OpenTrons/Smoothieboard/original_smoothieboard/README.md

Smoothieboard
=============

Smoothieboard is a free, open source, high performance and modular G-code interpreter and CNC controller for the LPC17xx micro-controller (32-bit ARM Cortex-M3).

The current BoM (Bill of Materials) can be found at https://docs.google.com/spreadsheet/ccc?key=0Api7_ZbfikkKdGRDblUwMDFWcm1CT2M2bENkQWpZZ0E&usp=drive_web#gid=0

A separate list is maintained for the connectors at https://docs.google.com/spreadsheets/d/1bT7xw4z405cyhR7MyXegm4-C2oinxpVefuf3KV13v_A/edit#gid=0

Licensed under CERN OHL v.1.2 or later http://ohwr.org/cernohl
No warranty is provided for this documentation implied or otherwise.

The policy regarding third party "clones" and "derivatives" of Smoothieboard is found at http://smoothieware.org/policy

This documentation is hosted at http://github.com/Smoothieware/Smoothieboard

Firmware is found at http://github.com/Smoothieware/Smoothieware

Documentation of use is hosted on a wiki at http://smoothieware.org

For more info or to let us know what you are doing with Smoothie email wolf.arthur@gmail.com
or join the Smoothie community on IRC Freenode in #smoothieware http://smoothieware.org/irc

Smoothieware is a certified open source hardware project (UID FR000001).

Smoothieboard, and Smoothieware, and the Smoothie-namespace are all trademarks of The Smoothie Project.
The hardware and software of The Smoothie Project are licensed under the CERN OHL v1.2 or later and GPL v3 or later licensing agreements respectively.
Copyright 2011-2016 by Arthur Wolf and Mark Cooper
