OpenTrons/Smoothieboard/original_smoothieboard/smoothieboard-5driver-schematic.pdf

A

A

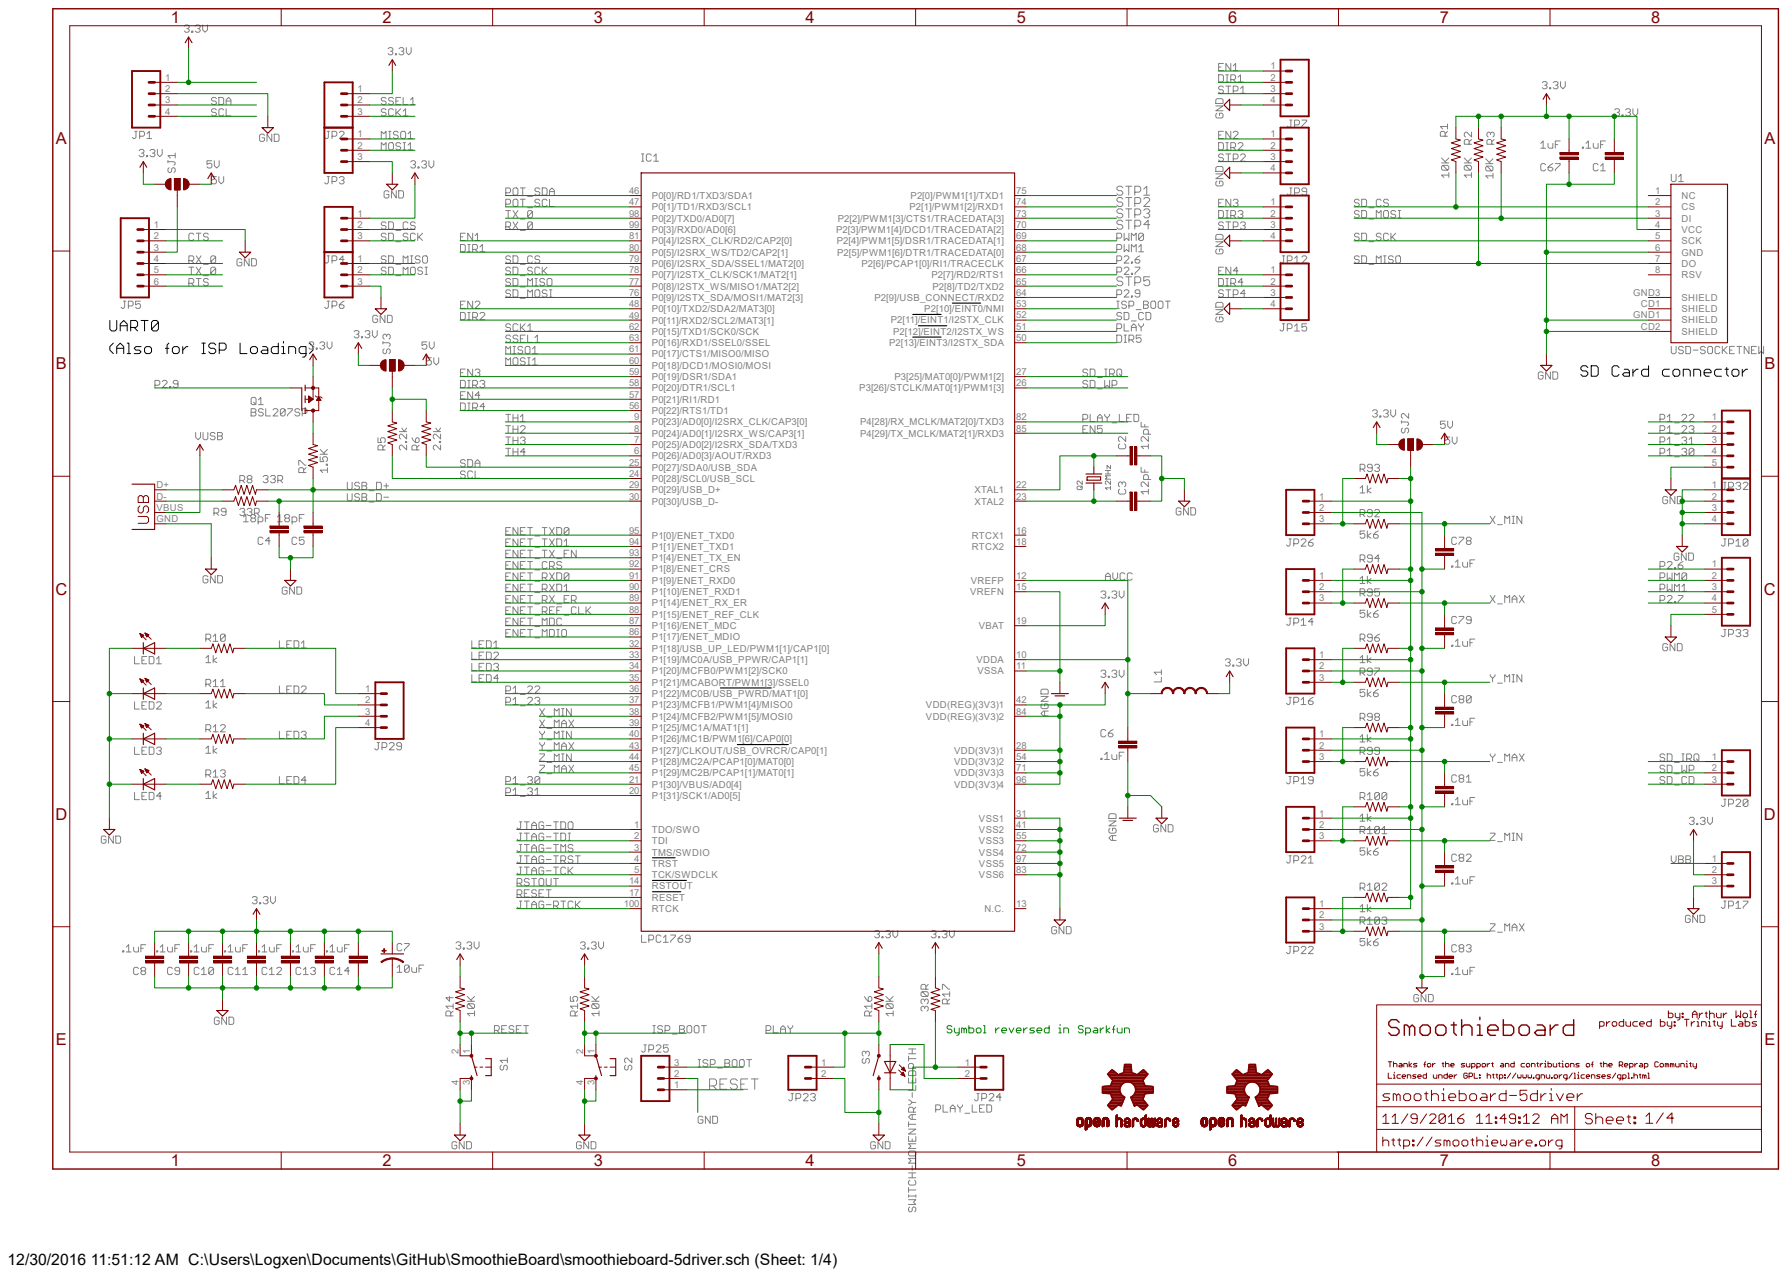
[picture p1: page 1]
TDO/SWO 1 TDI 2 TMS/SWDIO 3 TRST 4 TCK/SWDCLK 5; P0[26]/AD0[3]/AOUT/RXD3 6 P0[25]/AD0[2]/I2SRX_SDA/TXD3 7 P0[24]/AD0[1]/I2SRX_WS/CAP3[1] 8 P0[23]/AD0[0]/I2SRX_CLK/CAP3[0] 9; VDDA 10 VSSA 11; VREFP 12; RSTOUT 14; VREFN 15; RTCX1 16; RESET 17; RTCX2 18; VBAT 19; P1[31]/SCK1/AD0[5] 20 P1[30]/VBUS/AD0[4] 21; XTAL1 22 XTAL2 23; P0[28]/SCL0/USB_SCL 24 P0[27]/SDA0/USB_SDA 25; P3[26]/STCLK/MAT0[1]/PWM1[3] 26 P3[25]/MAT0[0]/PWM1[2] 27; VDD(3V3)1 28; P0[29]/USB_D+ 29 P0[30]/USB_D- 30; VSS1 31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

P2[9]/USB_CONNECT/RXD2 64 P2[8]/TD2/TXD2 65 P2[7]/RD2/RTS1 66 P2[6]/PCAP1[0]/RI1/TRACECLK 67 P2[5]/PWM1[6]/DTR1/TRACEDATA[0] 68 P2[4]/PWM1[5]/DSR1/TRACEDATA[1] 69 P2[3]/PWM1[4]/DCD1/TRACEDATA[2] 70

12/30/2016 11:51:12 AM C:\Users\Logxen\Documents\GitHub\SmoothieBoard\smoothieboard-5driver.sch (Sheet: 1/4)

A

A

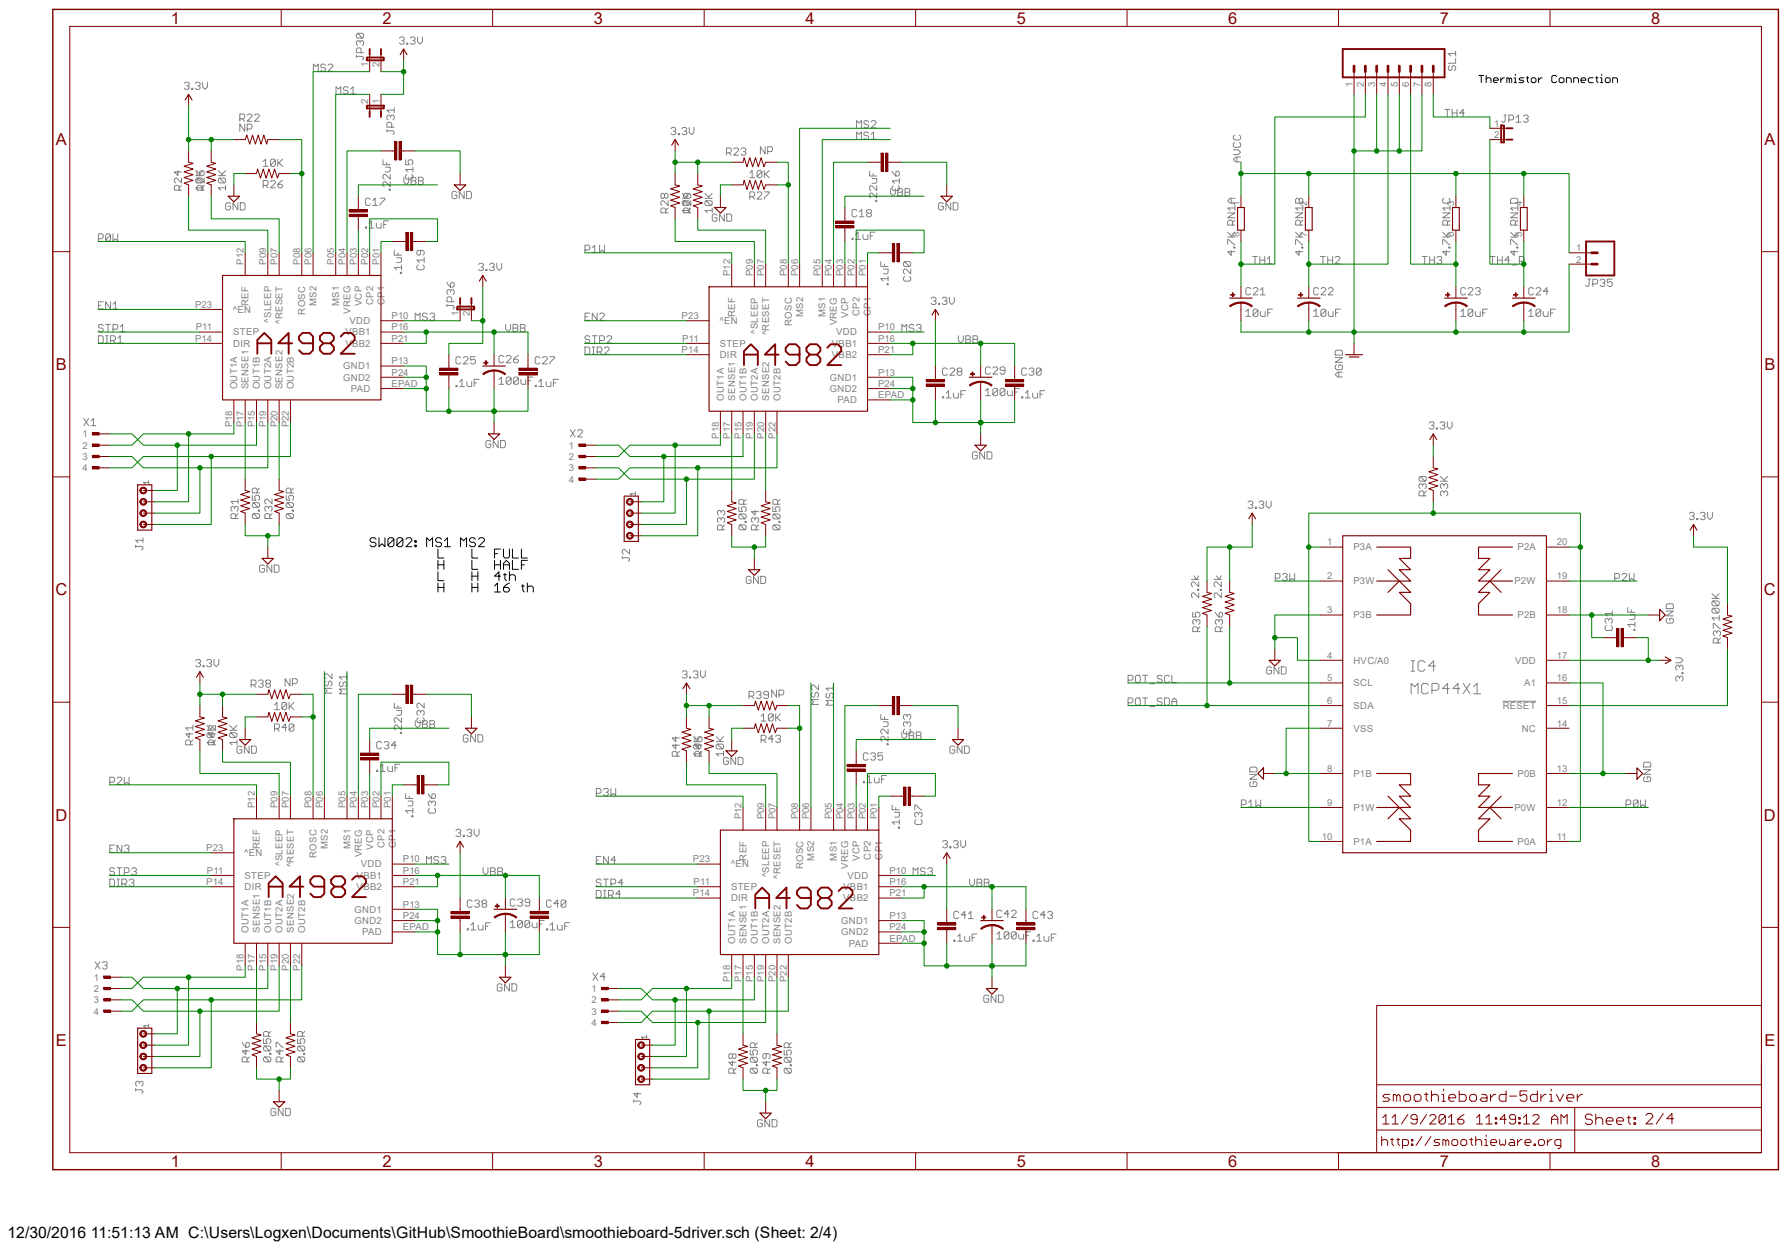
[picture p2: page 2]

12/30/2016 11:51:13 AM C:\Users\Logxen\Documents\GitHub\SmoothieBoard\smoothieboard-5driver.sch (Sheet: 2/4)

A

A

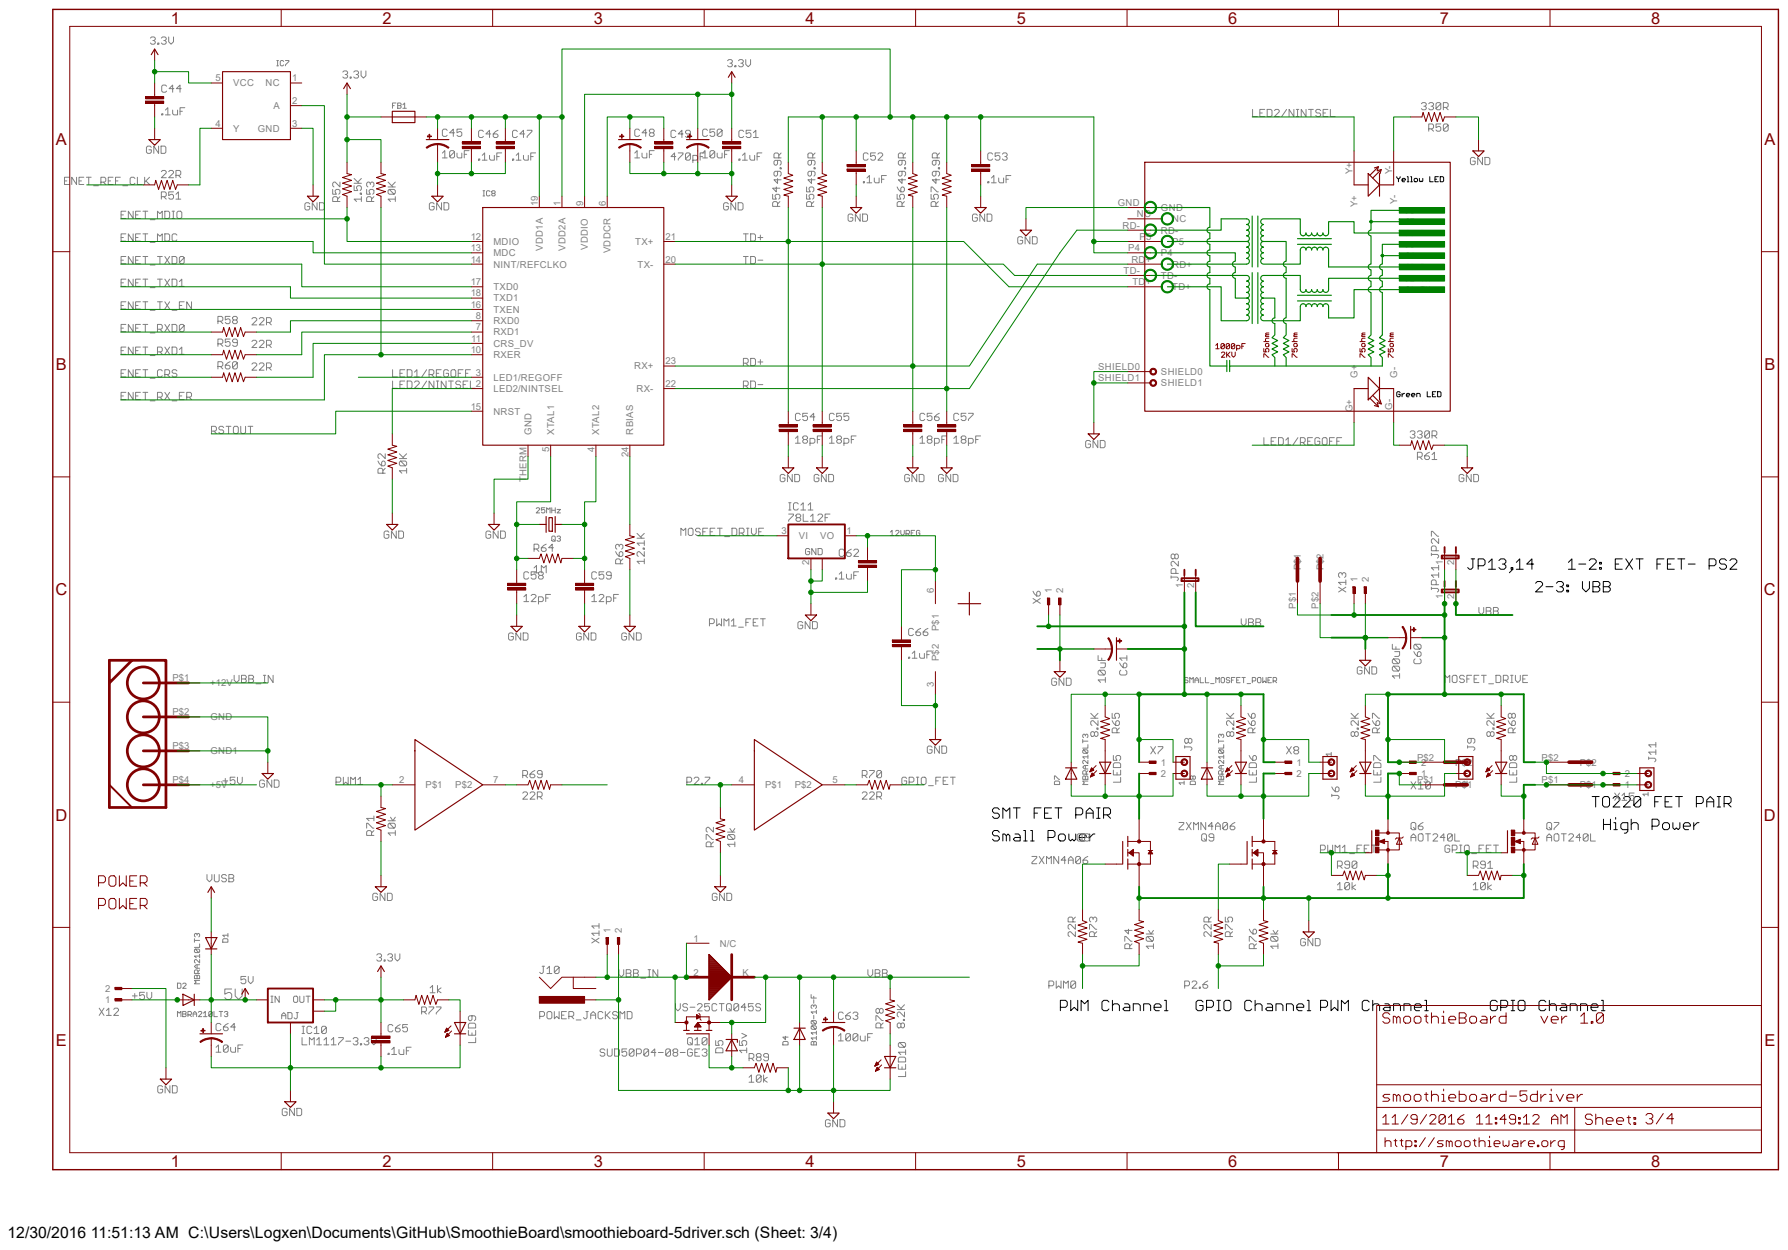
[picture p3: page 3]
MDIO 12 MDC 13 NINT/REFCLKO 14; TXD0 17 TXD1 18 TXEN 16 RXD0 8 RXD1 7; RXER 10; LED1/REGOFF 3 LED2/NINTSEL 2; NRST 15; XTAL1; XTAL2; CRS_DV 11; RBIAS 24; GND THERM; VDD1A 19; VDD2A; VDDIO; VDDCR; GND 3 Y 4; VCC 5; GND P$2; GND1 P$3; SHIELD0 SHIELD0 SHIELD1 SHIELD1

GND

12/30/2016 11:51:13 AM C:\Users\Logxen\Documents\GitHub\SmoothieBoard\smoothieboard-5driver.sch (Sheet: 3/4)

A

A

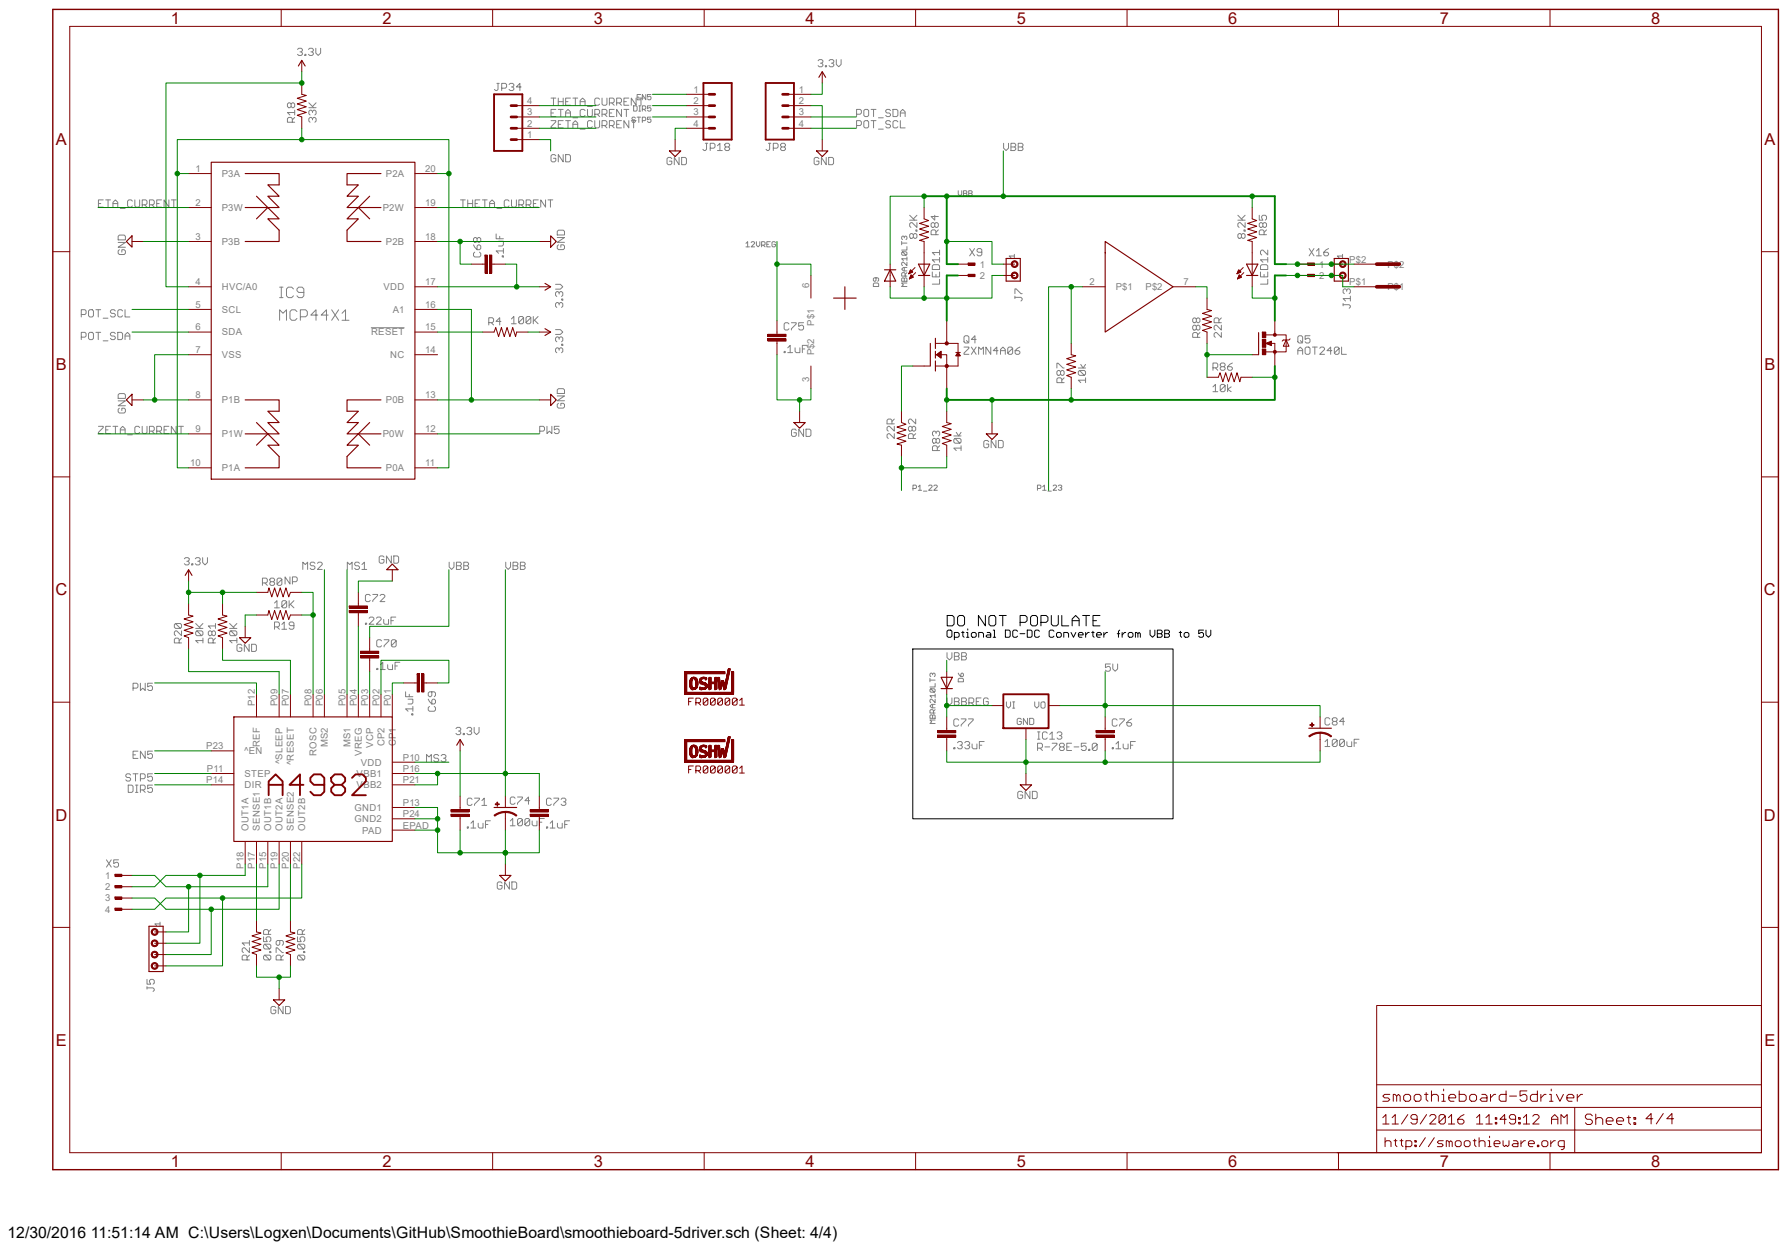
[picture p4: page 4]

12/30/2016 11:51:14 AM C:\Users\Logxen\Documents\GitHub\SmoothieBoard\smoothieboard-5driver.sch (Sheet: 4/4)
