OpenTrons/Smoothieboard/Opentrons_smoothieboard-5driver.pdf

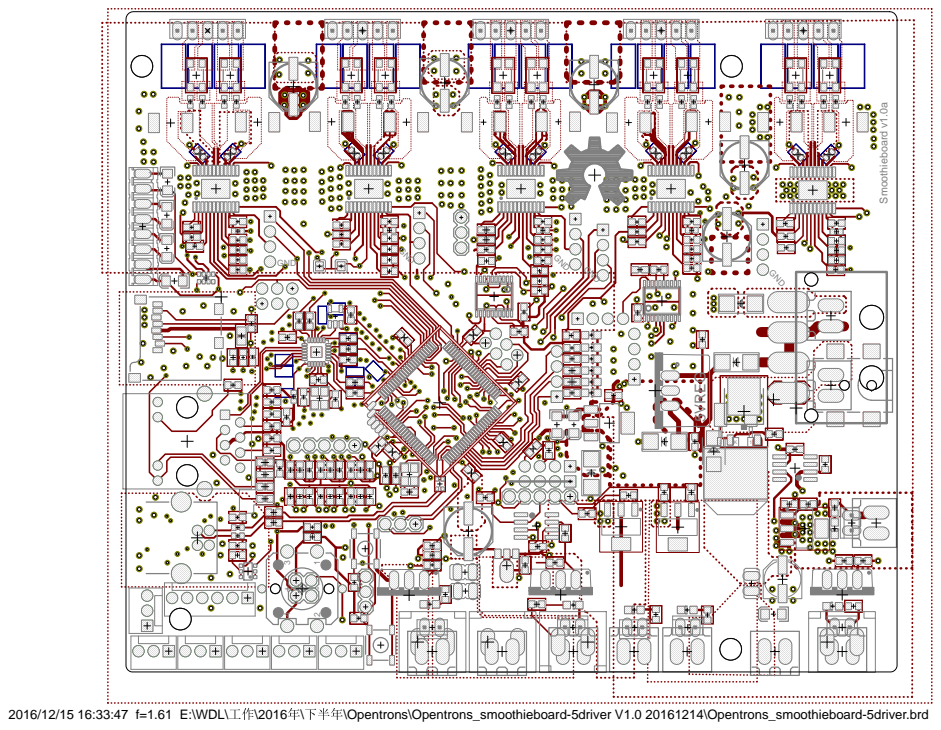
[picture p5: page 1]
2016/12/15 16:33:47 f=1.61 E:\WDL\; \Opentrons\Opentrons_smoothieboard-5driver V1.0 20161214\Opentrons_smoothieboard-5driver.brd; Smoothieboard v1.0a; 5VREG; GND; GND GND
