OpenTrons/Smoothieboard/Opentrons_smoothieboard-5driver.brd

## EAGLE design Opentrons_smoothieboard-5driver.brd (2017-04-06)

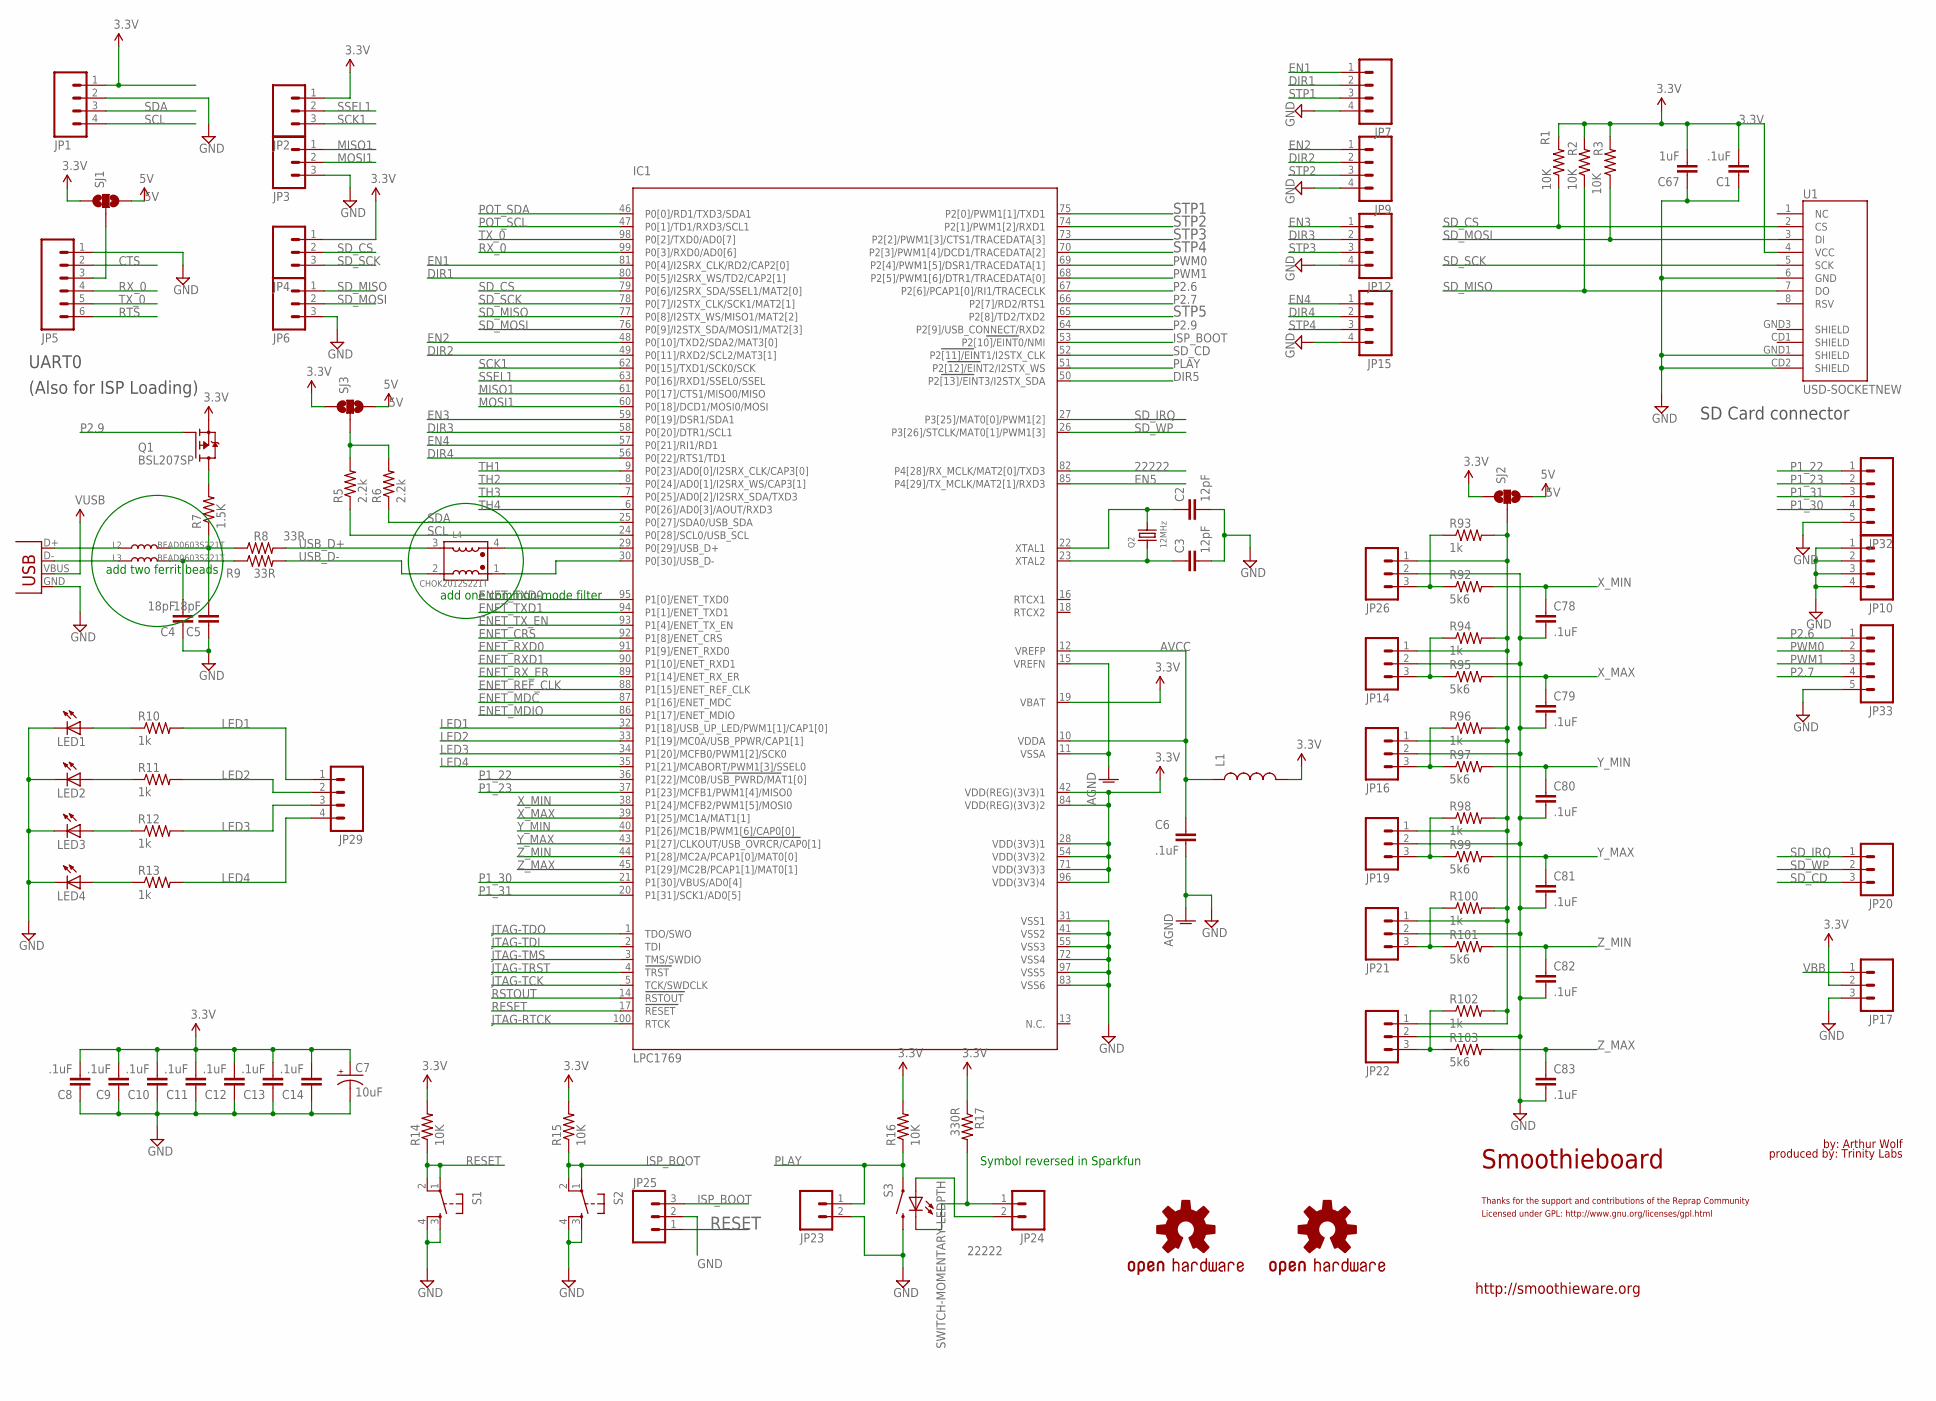
[picture p6: schematic Opentrons_smoothieboard-5driver.sch, sheet 1]

Parts:
C1, C6, C8, C9, C10, C11, C12, C13, C14, C78, C79, C80, C81, C82, C83: .1uF; C0603
C2, C3: 12pF; C0603
C4, C5: 18pF; C0603
C7: 10uF; EIA3216
C67: 1uF; C0805
IC1: LPC1769; LQFP100
JP1, JP7, JP9, JP10, JP12, JP15, JP29: M041X04_NO_SILK; 1X04_NO_SILK
JP2, JP3, JP4, JP6: M031X03_NO_SILK; 1X03_NO_SILK
JP5: M06POLAR; MOLEX-1X6
JP14, JP16, JP19, JP21, JP22, JP26: M03POLAR; MOLEX-1X3
JP17, JP20, JP25: M03PTH; 1X03
JP23, JP24: M02PTH; 1X02
JP32, JP33: M05PTH; 1X05
L1: INDUCTOR0603; 0603
L2, L3: BEAD0603S221T; 0603(1608)
L4: CHOK2012S221T; L-2012
LED1, LED2, LED3, LED4: LEDCHIP-LED0805; CHIP-LED0805
Q1: BSL207SP; SC74_INFINEON
Q2: 12MHz; CRYSTAL_3.2X2.5
R1, R2, R3, R14, R15, R16: 10K; R0603
R5, R6: 2.2k; R0603
R7: 1.5K; R0603
R8, R9: 33R; R0603
R10, R11, R12, R13, R93, R94, R96, R98, R100, R102: 1k; R0603
R17: 330R; R0603
R92, R95, R97, R99, R101, R103: 5k6; R0603
S1, S2: TAC_SWITCHSMD; TACTILE_SWITCH_SMD
S3: SWITCH-MOMENTARY-LEDPTH; TACTILE-PTH-LED-12MM
SJ1, SJ2, SJ3: SOLDERJUMPER_2WAYS; SJ_3
U1: USD-SOCKETNEW; MICRO-SD-SOCKET-PP
U$8, U$9: OSHW-LOGOH; OSHW-LOGO-HUGE
X14: USBPTH; USB-B-PTH

Connections:
3.3V: C1.2, C7.A (+), C8.2, C9.2, C10.2, C11.2, C12.2, C13.2, C14.2, C67.2, IC1.19 (VBAT), IC1.28 (VDD(3V3)1), IC1.42 (VDD(REG)(3V3)1), IC1.54 (VDD(3V3)2), IC1.71 (VDD(3V3)3), IC1.84 (VDD(REG)(3V3)2), IC1.96 (VDD(3V3)4), JP1.1, JP2.1, JP4.1, JP17.2, L1.2, Q1.4 (S), R1.2, R2.2, R3.2, R14.2, R15.2, R16.2, R17.1, SJ1.1, SJ2.1, SJ3.1, U1.4 (VCC); also elsewhere on the board
5V: SJ1.3, SJ2.3, SJ3.3; also elsewhere on the board
22222: IC1.82 (P4[28]/RX_MCLK/MAT2[0]/TXD3), JP24.2, S3.A
AGND: C6.2, IC1.11 (VSSA), IC1.15 (VREFN); also elsewhere on the board
AVCC: C6.1, IC1.10 (VDDA), IC1.12 (VREFP), L1.1; also elsewhere on the board
CTS: JP5.2
DIR1: IC1.80 (P0[5]/I2SRX_WS/TD2/CAP2[1]), JP7.2; also elsewhere on the board
DIR2: IC1.49 (P0[11]/RXD2/SCL2/MAT3[1]), JP9.2; also elsewhere on the board
DIR3: IC1.58 (P0[20]/DTR1/SCL1), JP12.2; also elsewhere on the board
DIR4: IC1.56 (P0[22]/RTS1/TD1), JP15.2; also elsewhere on the board
DIR5: IC1.50 (P2[13]/EINT3/I2STX_SDA); also elsewhere on the board
EN1: IC1.81 (P0[4]/I2SRX_CLK/RD2/CAP2[0]), JP7.1; also elsewhere on the board
EN2: IC1.48 (P0[10]/TXD2/SDA2/MAT3[0]), JP9.1; also elsewhere on the board
EN3: IC1.59 (P0[19]/DSR1/SDA1), JP12.1; also elsewhere on the board
EN4: IC1.57 (P0[21]/RI1/RD1), JP15.1; also elsewhere on the board
EN5: IC1.85 (P4[29]/TX_MCLK/MAT2[1]/RXD3); also elsewhere on the board
ENET_CRS: IC1.92 (P1[8]/ENET_CRS); also elsewhere on the board
ENET_MDC: IC1.87 (P1[16]/ENET_MDC); also elsewhere on the board
ENET_MDIO: IC1.86 (P1[17]/ENET_MDIO); also elsewhere on the board
ENET_REF_CLK: IC1.88 (P1[15]/ENET_REF_CLK); also elsewhere on the board
ENET_RXD0: IC1.91 (P1[9]/ENET_RXD0); also elsewhere on the board
ENET_RXD1: IC1.90 (P1[10]/ENET_RXD1); also elsewhere on the board
ENET_RX_ER: IC1.89 (P1[14]/ENET_RX_ER); also elsewhere on the board
ENET_TXD0: IC1.95 (P1[0]/ENET_TXD0); also elsewhere on the board
ENET_TXD1: IC1.94 (P1[1]/ENET_TXD1); also elsewhere on the board
ENET_TX_EN: IC1.93 (P1[4]/ENET_TX_EN); also elsewhere on the board
GND: C1.1, C2.2, C3.2, C4.1, C5.1, C7.C (-), C8.1, C9.1, C10.1, C11.1, C12.1, C13.1, C14.1, C67.1, C78.2, C79.2, C80.2, C81.2, C82.2, C83.2, IC1.31 (VSS1), IC1.41 (VSS2), IC1.55 (VSS3), IC1.72 (VSS4), IC1.83 (VSS6), IC1.97 (VSS5), JP1.2, JP3.3, JP5.1, JP6.3, JP7.4, JP9.4, JP10.1, JP10.2, JP10.3, JP10.4, JP12.4, JP14.2, JP15.4, JP16.2, JP17.3, JP19.2, JP21.2, JP22.2, JP23.2, JP25.2, JP26.2, JP32.5, JP33.5, LED1.C, LED2.C, LED3.C, LED4.C, S1.3, S1.4, S2.3, S2.4, S3.2, U1.6 (GND), U1.CD2 (SHIELD), U1.GND1 (SHIELD), X14.GND; also elsewhere on the board
ISP_BOOT: IC1.53 (P2[10]/EINT0/NMI), JP25.3, R15.1, S2.1, S2.2
JTAG-RTCK: IC1.100 (RTCK)
JTAG-TCK: IC1.5 (TCK/SWDCLK)
JTAG-TDI: IC1.2 (TDI)
JTAG-TDO: IC1.1 (TDO/SWO)
JTAG-TMS: IC1.3 (TMS/SWDIO)
JTAG-TRST: IC1.4 (TRST)
LED1: IC1.32 (P1[18]/USB_UP_LED/PWM1[1]/CAP1[0]), JP29.1, R10.2
LED2: IC1.33 (P1[19]/MC0A/USB_PPWR/CAP1[1]), JP29.2, R11.2
LED3: IC1.34 (P1[20]/MCFB0/PWM1[2]/SCK0), JP29.3, R12.2
LED4: IC1.35 (P1[21]/MCABORT/PWM1[3]/SSEL0), JP29.4, R13.2
MISO1: IC1.61 (P0[17]/CTS1/MISO0/MISO), JP3.1
MOSI1: IC1.60 (P0[18]/DCD1/MOSI0/MOSI), JP3.2
unnamed: C2.1, IC1.22 (XTAL1), Q2.2
unnamed: C3.1, IC1.23 (XTAL2), Q2.1
unnamed: JP5.3, SJ1.2
unnamed: Q1.1 (D), Q1.2 (D), Q1.5 (D), Q1.6 (D), R7.2
unnamed: L2.1, X14.D+
unnamed: L3.1, X14.D-
unnamed: JP24.1, R17.2, S3.C
unnamed: LED4.A, R13.1
unnamed: LED3.A, R12.1
unnamed: LED2.A, R11.1
unnamed: LED1.A, R10.1
unnamed: JP14.3, R94.1, R95.1
unnamed: JP14.1, JP16.1, JP19.1, JP21.1, JP22.1, JP26.1, R93.2, R94.2, R96.2, R98.2, R100.2, R102.2, SJ2.2
unnamed: JP16.3, R96.1, R97.1
unnamed: JP19.3, R98.1, R99.1
unnamed: JP22.3, R102.1, R103.1
unnamed: JP21.3, R100.1, R101.1
unnamed: JP26.3, R92.1, R93.1
unnamed: R5.2, R6.2, SJ3.2
unnamed: C5.2, L2.2, R7.1, R8.1
unnamed: C4.2, L3.2, R9.1
unnamed: IC1.30 (P0[30]/USB_D-), L4.1
unnamed: IC1.29 (P0[29]/USB_D+), L4.4
P1_22: IC1.36 (P1[22]/MC0B/USB_PWRD/MAT1[0]), JP32.1; also elsewhere on the board
P1_23: IC1.37 (P1[23]/MCFB1/PWM1[4]/MISO0), JP32.2; also elsewhere on the board
P1_30: IC1.21 (P1[30]/VBUS/AD0[4]), JP32.4
P1_31: IC1.20 (P1[31]/SCK1/AD0[5]), JP32.3
P2.6: IC1.67 (P2[6]/PCAP1[0]/RI1/TRACECLK), JP33.1; also elsewhere on the board
P2.7: IC1.66 (P2[7]/RD2/RTS1), JP33.4; also elsewhere on the board
P2.9: IC1.64 (P2[9]/USB_CONNECT/RXD2), Q1.3 (G)
PLAY: IC1.51 (P2[12]/EINT2/I2STX_WS), JP23.1, R16.1, S3.4 (1)
POT_SCL: IC1.47 (P0[1]/TD1/RXD3/SCL1); also elsewhere on the board
POT_SDA: IC1.46 (P0[0]/RD1/TXD3/SDA1); also elsewhere on the board
PWM0: IC1.69 (P2[4]/PWM1[5]/DSR1/TRACEDATA[1]), JP33.2; also elsewhere on the board
PWM1: IC1.68 (P2[5]/PWM1[6]/DTR1/TRACEDATA[0]), JP33.3; also elsewhere on the board
RESET: IC1.17 (RESET), JP25.1, R14.1, S1.1, S1.2
RSTOUT: IC1.14 (RSTOUT); also elsewhere on the board
RTS: JP5.6
RX_0: IC1.99 (P0[3]/RXD0/AD0[6]), JP5.4
SCK1: IC1.62 (P0[15]/TXD1/SCK0/SCK), JP2.3
SCL: IC1.24 (P0[28]/SCL0/USB_SCL), JP1.4, R5.1
SDA: IC1.25 (P0[27]/SDA0/USB_SDA), JP1.3, R6.1
SD_CD: IC1.52 (P2[11]/EINT1/I2STX_CLK), JP20.3
SD_CS: IC1.79 (P0[6]/I2SRX_SDA/SSEL1/MAT2[0]), JP4.2, R1.1, U1.2 (CS)
SD_IRQ: IC1.27 (P3[25]/MAT0[0]/PWM1[2]), JP20.1
SD_MISO: IC1.77 (P0[8]/I2STX_WS/MISO1/MAT2[2]), JP6.1, R2.1, U1.7 (DO)
SD_MOSI: IC1.76 (P0[9]/I2STX_SDA/MOSI1/MAT2[3]), JP6.2, R3.1, U1.3 (DI)
SD_SCK: IC1.78 (P0[7]/I2STX_CLK/SCK1/MAT2[1]), JP4.3, U1.5 (SCK)
SD_WP: IC1.26 (P3[26]/STCLK/MAT0[1]/PWM1[3]), JP20.2
SSEL1: IC1.63 (P0[16]/RXD1/SSEL0/SSEL), JP2.2
STP1: IC1.75 (P2[0]/PWM1[1]/TXD1), JP7.3; also elsewhere on the board
STP2: IC1.74 (P2[1]/PWM1[2]/RXD1), JP9.3; also elsewhere on the board
STP3: IC1.73 (P2[2]/PWM1[3]/CTS1/TRACEDATA[3]), JP12.3; also elsewhere on the board
STP4: IC1.70 (P2[3]/PWM1[4]/DCD1/TRACEDATA[2]), JP15.3; also elsewhere on the board
STP5: IC1.65 (P2[8]/TD2/TXD2); also elsewhere on the board
TH1: IC1.9 (P0[23]/AD0[0]/I2SRX_CLK/CAP3[0]); also elsewhere on the board
TH2: IC1.8 (P0[24]/AD0[1]/I2SRX_WS/CAP3[1]); also elsewhere on the board
TH3: IC1.7 (P0[25]/AD0[2]/I2SRX_SDA/TXD3); also elsewhere on the board
TH4: IC1.6 (P0[26]/AD0[3]/AOUT/RXD3); also elsewhere on the board
TX_0: IC1.98 (P0[2]/TXD0/AD0[7]), JP5.5
USB_D+: L4.3, R8.2
USB_D-: L4.2, R9.2
VBB: JP17.1; also elsewhere on the board
VUSB: X14.VBUS; also elsewhere on the board
X_MAX: C79.1, IC1.39 (P1[25]/MC1A/MAT1[1]), R95.2
X_MIN: C78.1, IC1.38 (P1[24]/MCFB2/PWM1[5]/MOSI0), R92.2
Y_MAX: C81.1, IC1.43 (P1[27]/CLKOUT/USB_OVRCR/CAP0[1]), R99.2
Y_MIN: C80.1, IC1.40 (P1[26]/MC1B/PWM1[6]/CAP0[0]), R97.2
Z_MAX: C83.1, IC1.45 (P1[29]/MC2B/PCAP1[1]/MAT0[1]), R103.2
Z_MIN: C82.1, IC1.44 (P1[28]/MC2A/PCAP1[0]/MAT0[0]), R101.2

Notes on the sheet:
SD Card connector
UART0
(Also for ISP Loading)
http://smoothieware.org
Symbol reversed in Sparkfun
Smoothieboard
by: Arthur Wolf
produced by: Trinity Labs
Licensed under GPL: http://www.gnu.org/licenses/gpl.html
Thanks for the support and contributions of the Reprap Community
add two ferrit beads
add one common-mode filter

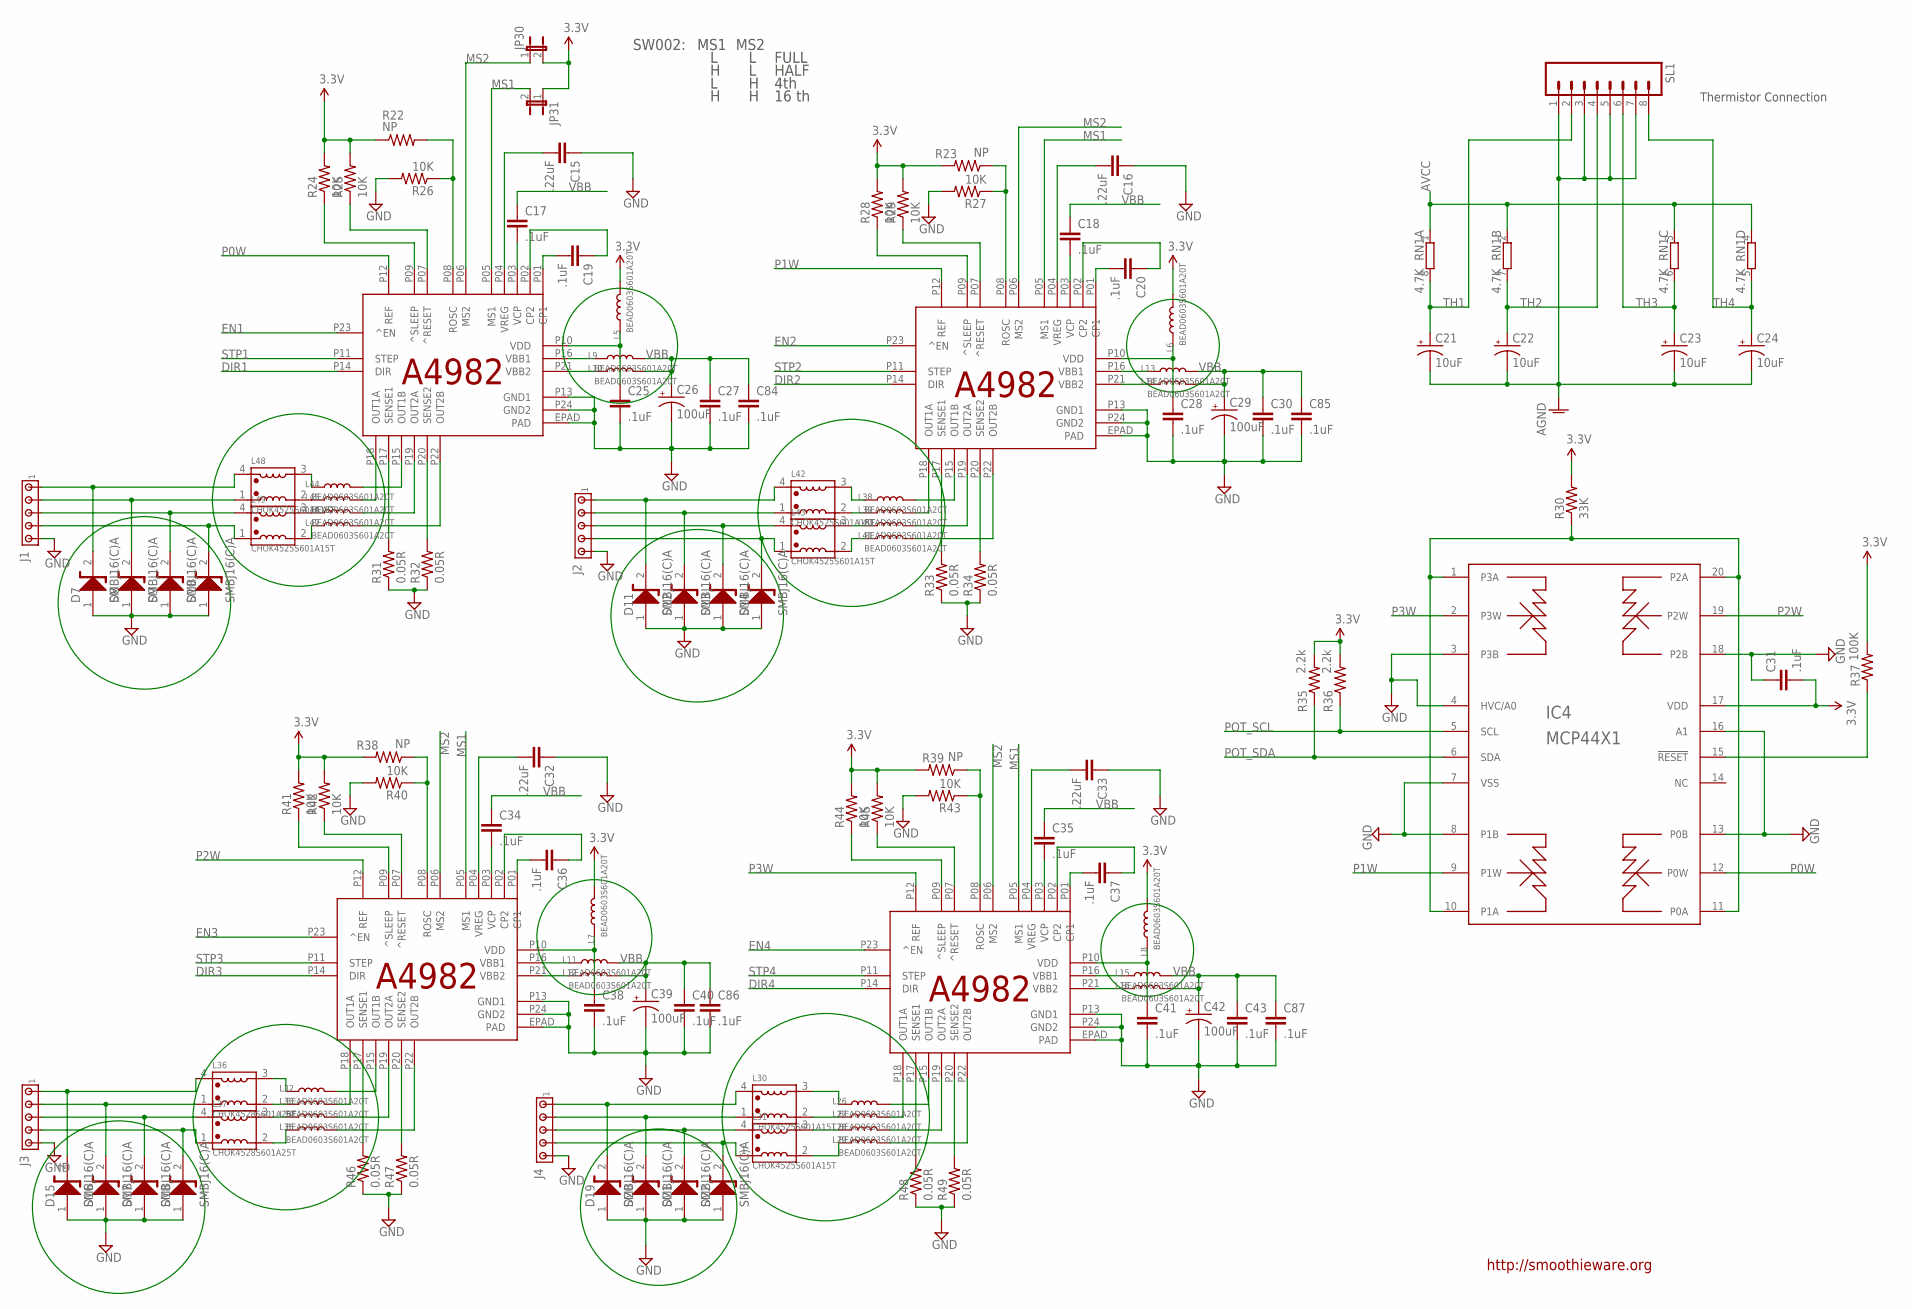
[picture p7: schematic Opentrons_smoothieboard-5driver.sch, sheet 2]

Parts:
C15, C16, C32, C33: .22uF; C0603
C17, C18, C19, C20, C25, C27, C28, C30, C31, C34, C35, C36, C37, C38, C40, C41, C43, C84, C85, C86, C87: .1uF; C0603
C21, C22, C23, C24: 10uF; EIA3216
C26, C29, C39, C42: 100uF; PANASONIC_E
D7, D8, D9, D10, D11, D12, D13, D14, D15, D16, D17, D18, D19, D20, D21, D22: SMBJ16(C)A; DO214-AA_(SMB)
IC2, IC3, IC5, IC6: A4982; ETSSOP24
IC4: MCP44X1; TSSOP20
J1, J2, J3, J4: MTA05-100; 10X05MTA
JP30, JP31: JUMPER-2SMD-NC; SJ_2S
L5, L6, L7, L8, L9, L10, L11, L12, L13, L14, L15, L16, L26, L27, L28, L29, L32, L33, L34, L35, L38, L39, L40, L41, L44, L45, L46, L47: BEAD0603S601A20T; 0603(1608)
L30, L31, L42, L43, L48, L49: CHOK4525S601A15T; L-4525
L36, L37: CHOK4528S601A25T; L-4528
R22, R23, R38, R39: NP; R0603
R24, R25, R26, R27, R28, R29, R40, R41, R42, R43, R44, R45: 10K; R0603
R30: 33K; R0603
R31, R32, R33, R34, R46, R47, R48, R49: 0.05R; R2512
R35, R36: 2.2k; R0603
R37: 100K; R0603
RN1: 4.7K; 0603-ARV
SL1: M08; 08P

Connections:
3.3V: C31.2, IC4.17 (VDD), JP30.2, JP31.1, L5.2, L6.2, L7.2, L8.2, R22.1, R23.2, R24.2, R25.2, R28.2, R29.2, R30.2, R35.2, R36.2, R37.2, R38.2, R39.2, R41.2, R42.2, R44.2, R45.2; also elsewhere on the board
AGND: C21.C (-), C22.C (-), C23.C (-), C24.C (-), SL1.1, SL1.3, SL1.5, SL1.7; also elsewhere on the board
AVCC: RN1.1, RN1.2 (1), RN1.3 (1), RN1.4 (1); also elsewhere on the board
DIR1: IC2.P14 (DIR); also elsewhere on the board
DIR2: IC3.P14 (DIR); also elsewhere on the board
DIR3: IC5.P14 (DIR); also elsewhere on the board
DIR4: IC6.P14 (DIR); also elsewhere on the board
EN1: IC2.P23 (^EN); also elsewhere on the board
EN2: IC3.P23 (^EN); also elsewhere on the board
EN3: IC5.P23 (^EN); also elsewhere on the board
EN4: IC6.P23 (^EN); also elsewhere on the board
GND: C15.1, C16.1, C25.2, C26.-, C27.2, C28.2, C29.-, C30.2, C31.1, C32.1, C33.1, C38.2, C39.-, C40.2, C41.2, C42.-, C43.2, C84.2, C85.2, C86.2, C87.2, D7.1 (A), D8.1 (A), D9.1 (A), D10.1 (A), D11.1 (A), D12.1 (A), D13.1 (A), D14.1 (A), D15.1 (A), D16.1 (A), D17.1 (A), D18.1 (A), D19.1 (A), D20.1 (A), D21.1 (A), D22.1 (A), IC2.EPAD (PAD), IC2.P13 (GND1), IC2.P24 (GND2), IC3.EPAD (PAD), IC3.P13 (GND1), IC3.P24 (GND2), IC4.3 (P3B), IC4.4 (HVC/A0), IC4.7 (VSS), IC4.8 (P1B), IC4.13 (P0B), IC4.16 (A1), IC4.18 (P2B), IC5.EPAD (PAD), IC5.P13 (GND1), IC5.P24 (GND2), IC6.EPAD (PAD), IC6.P13 (GND1), IC6.P24 (GND2), J1.5, J2.5, J3.5, J4.5, R26.2, R27.2, R31.1, R32.1, R33.1, R34.1, R40.2, R43.2, R46.1, R47.1, R48.1, R49.1; also elsewhere on the board
J1_1A: D7.2 (K), J1.1, L48.4
J1_1B: D8.2 (K), J1.2, L48.1
J1_2A: D9.2 (K), J1.3, L49.4
J1_2B: D10.2 (K), J1.4, L49.1
J2_1A: D11.2 (K), J2.1, L42.4
J2_1B: D12.2 (K), J2.2, L42.1
J2_2A: D13.2 (K), J2.3, L43.4
J2_2B: D14.2 (K), J2.4, L43.1
J3_1A: D15.2 (K), J3.1, L36.4
J3_1B: D16.2 (K), J3.2, L36.1
J3_2A: D17.2 (K), J3.3, L37.4
J3_2B: D18.2 (K), J3.4, L37.1
J4_1A: D19.2 (K), J4.1, L30.4
J4_1B: D20.2 (K), J4.2, L30.1
J4_2A: D21.2 (K), J4.3, L31.4
J4_2B: D22.2 (K), J4.4, L31.1
MS1: IC2.P05 (MS1), IC3.P05 (MS1), IC5.P05 (MS1), IC6.P05 (MS1), JP31.2; also elsewhere on the board
MS2: IC2.P06 (MS2), IC3.P06 (MS2), IC5.P06 (MS2), IC6.P06 (MS2), JP30.1; also elsewhere on the board
unnamed: C20.2, IC3.P01 (CP1)
unnamed: C20.1, IC3.P02 (CP2)
unnamed: IC2.P07 (^RESET), R25.1
unnamed: C18.2, IC3.P03 (VCP)
unnamed: IC3.P17 (SENSE1), R33.2
unnamed: IC3.P20 (SENSE2), R34.2
unnamed: IC3.P18 (OUT1A), L39.2
unnamed: IC3.P19 (OUT2A), L40.2
unnamed: IC4.15 (!RESET), R37.1
unnamed: IC3.P22 (OUT2B), L41.2
unnamed: IC4.1 (P3A), IC4.10 (P1A), IC4.11 (P0A), IC4.20 (P2A), R30.1
unnamed: IC3.P08 (ROSC), R23.1, R27.1
unnamed: C16.2, IC3.P04 (VREG)
unnamed: IC3.P09 (^SLEEP), R28.1
unnamed: C36.2, IC5.P01 (CP1)
unnamed: C36.1, IC5.P02 (CP2)
unnamed: C34.2, IC5.P03 (VCP)
unnamed: IC5.P17 (SENSE1), R46.2
unnamed: IC5.P20 (SENSE2), R47.2
unnamed: IC5.P18 (OUT1A), L33.2
unnamed: IC5.P15 (OUT1B), L32.2
unnamed: IC5.P19 (OUT2A), L34.2
unnamed: IC5.P22 (OUT2B), L35.2
unnamed: IC3.P07 (^RESET), R29.1
unnamed: IC5.P07 (^RESET), R42.1
unnamed: IC5.P08 (ROSC), R38.1, R40.1
unnamed: C32.2, IC5.P04 (VREG)
unnamed: IC6.P07 (^RESET), R45.1
unnamed: IC5.P09 (^SLEEP), R41.1
unnamed: C37.2, IC6.P01 (CP1)
unnamed: C37.1, IC6.P02 (CP2)
unnamed: C35.2, IC6.P03 (VCP)
unnamed: IC6.P17 (SENSE1), R48.2
unnamed: IC6.P20 (SENSE2), R49.2
unnamed: IC6.P15 (OUT1B), L26.2
unnamed: IC6.P19 (OUT2A), L28.2
unnamed: IC6.P22 (OUT2B), L29.2
unnamed: IC6.P08 (ROSC), R39.1, R43.1
unnamed: C33.2, IC6.P04 (VREG)
unnamed: IC6.P09 (^SLEEP), R44.1
unnamed: IC6.P18 (OUT1A), L27.2
unnamed: C19.2, IC2.P01 (CP1)
unnamed: C19.1, IC2.P02 (CP2)
unnamed: C17.2, IC2.P03 (VCP)
unnamed: IC2.P17 (SENSE1), R31.2
unnamed: IC2.P20 (SENSE2), R32.2
unnamed: IC2.P18 (OUT1A), L45.2
unnamed: IC2.P15 (OUT1B), L44.2
unnamed: IC2.P19 (OUT2A), L46.2
unnamed: IC2.P22 (OUT2B), L47.2
unnamed: IC2.P08 (ROSC), R22.2, R26.1
unnamed: C15.2, IC2.P04 (VREG)
unnamed: IC2.P09 (^SLEEP), R24.1
unnamed: C25.1, IC2.P10 (VDD), L5.1
unnamed: C38.1, IC5.P10 (VDD), L7.1
unnamed: C28.1, IC3.P10 (VDD), L6.1
unnamed: C41.1, IC6.P10 (VDD), L8.1
unnamed: IC2.P16 (VBB1), L9.1
unnamed: IC2.P21 (VBB2), L10.1
unnamed: IC3.P16 (VBB1), L13.1
unnamed: IC3.P21 (VBB2), L14.1
unnamed: IC5.P16 (VBB1), L11.1
unnamed: IC5.P21 (VBB2), L12.1
unnamed: IC6.P16 (VBB1), L15.1
unnamed: IC6.P21 (VBB2), L16.1
unnamed: L26.1, L30.3
unnamed: L27.1, L30.2
unnamed: L28.1, L31.3
unnamed: L29.1, L31.2
unnamed: L33.1, L36.2
unnamed: L34.1, L37.3
unnamed: L32.1, L36.3
unnamed: L35.1, L37.2
unnamed: IC3.P15 (OUT1B), L38.2
unnamed: L40.1, L43.3
unnamed: L39.1, L42.2
unnamed: L41.1, L43.2
unnamed: L38.1, L42.3
unnamed: L45.1, L48.2
unnamed: L46.1, L49.3
unnamed: L44.1, L48.3
unnamed: L47.1, L49.2
P0W: IC2.P12 (REF), IC4.12 (P0W)
P1W: IC3.P12 (REF), IC4.9 (P1W)
P2W: IC4.19 (P2W), IC5.P12 (REF)
P3W: IC4.2 (P3W), IC6.P12 (REF)
POT_SCL: IC4.5 (SCL), R36.1; also elsewhere on the board
POT_SDA: IC4.6 (SDA), R35.1; also elsewhere on the board
STP1: IC2.P11 (STEP); also elsewhere on the board
STP2: IC3.P11 (STEP); also elsewhere on the board
STP3: IC5.P11 (STEP); also elsewhere on the board
STP4: IC6.P11 (STEP); also elsewhere on the board
TH1: C21.A (+), RN1.8 (2), SL1.2; also elsewhere on the board
TH2: C22.A (+), RN1.7 (2), SL1.4; also elsewhere on the board
TH3: C23.A (+), RN1.6 (2), SL1.6; also elsewhere on the board
TH4: C24.A (+), RN1.5 (2), SL1.8; also elsewhere on the board
VBB: C17.1, C18.1, C26.+, C27.1, C29.+, C30.1, C34.1, C35.1, C39.+, C40.1, C42.+, C43.1, C84.1, C85.1, C86.1, C87.1, L9.2, L10.2, L11.2, L12.2, L13.2, L14.2, L15.2, L16.2; also elsewhere on the board

Notes on the sheet:
SW002:
MS1
MS2
FULL
HALF
4th
16 th
Thermistor Connection
http://smoothieware.org

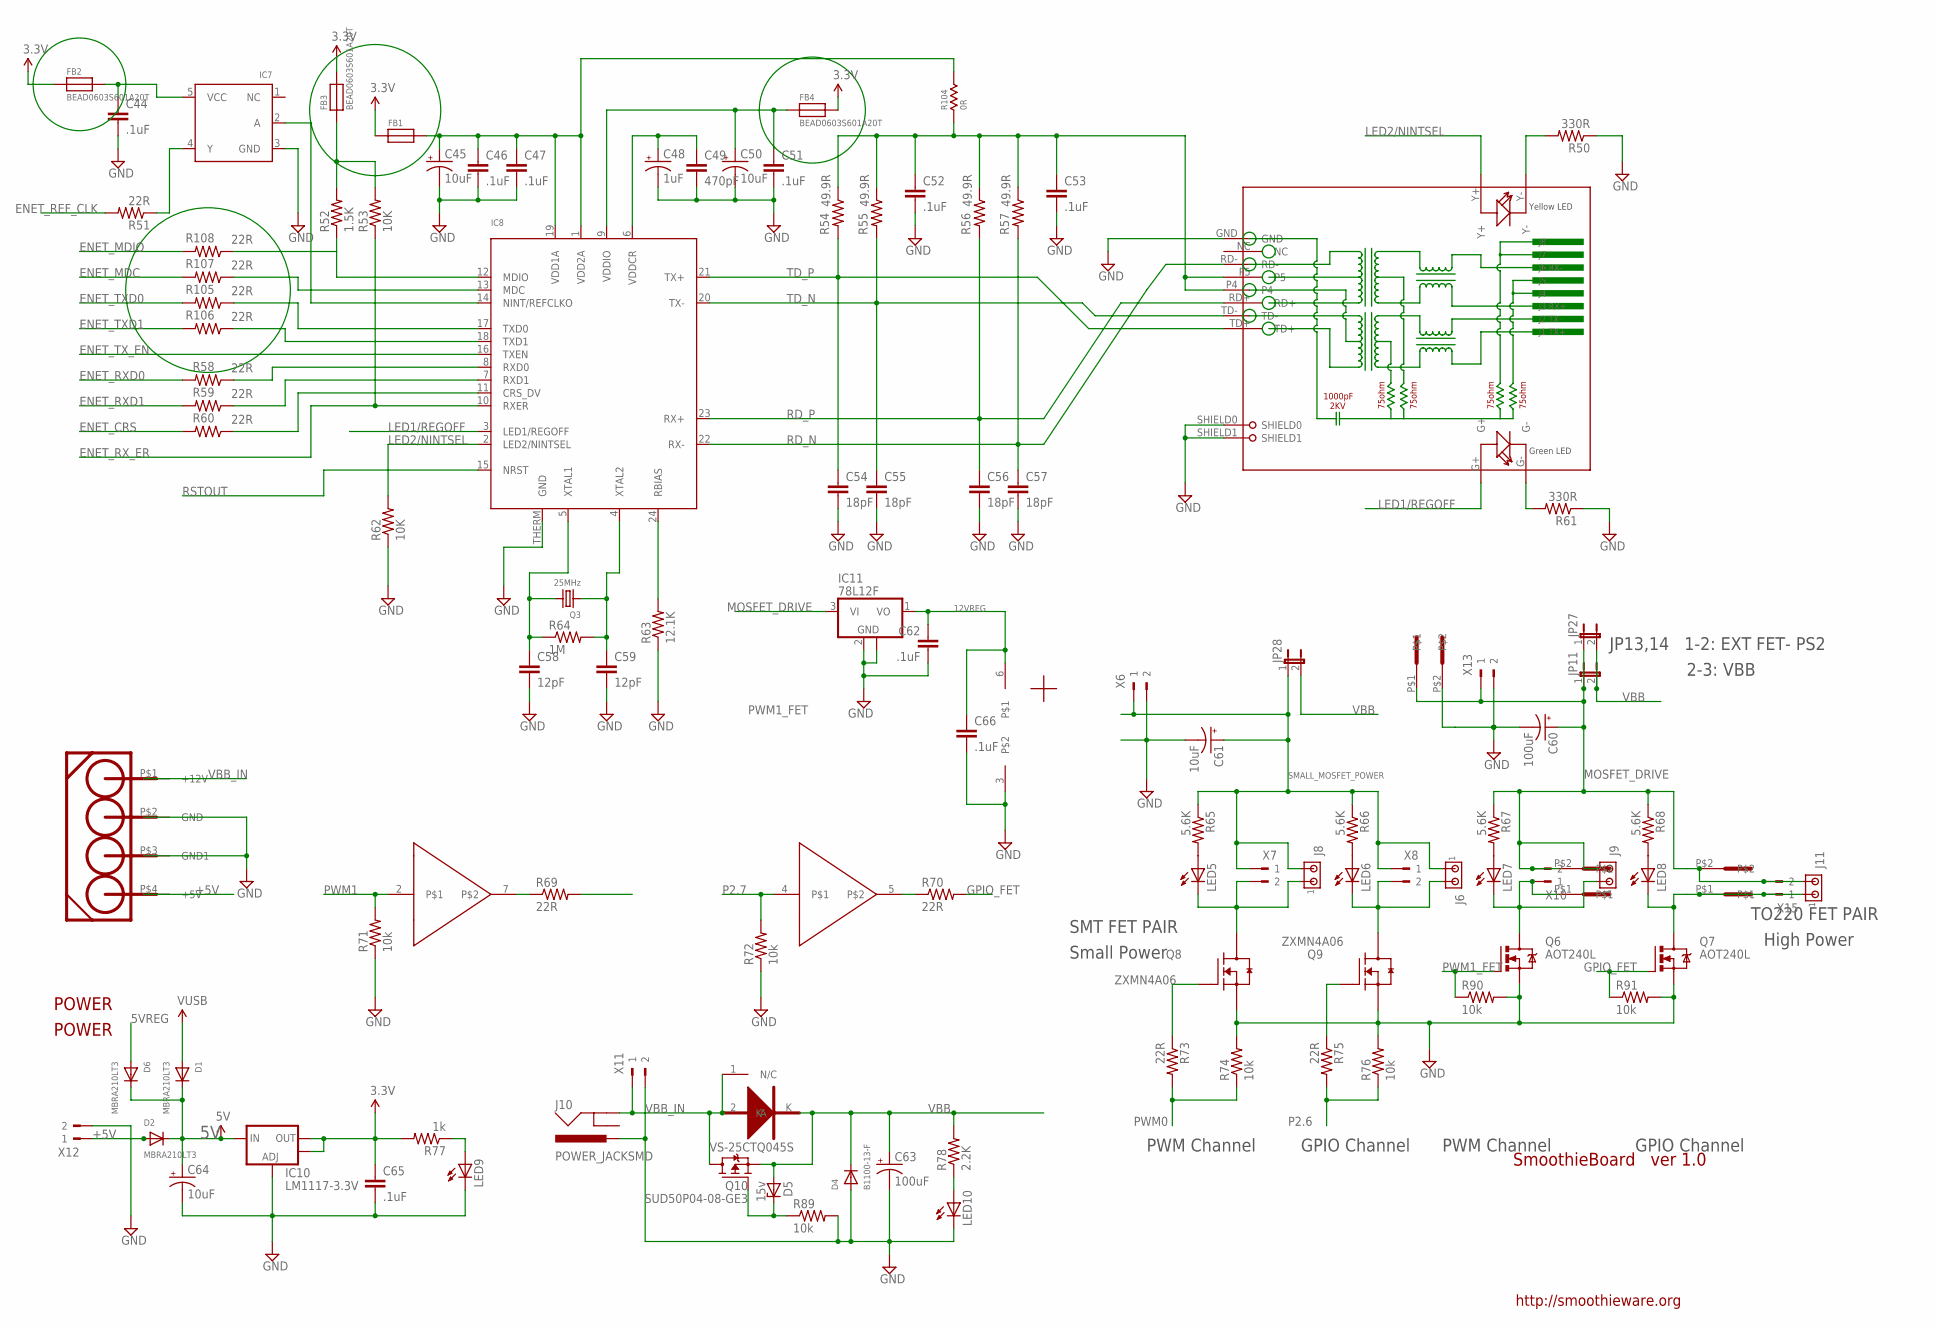
[picture p8: schematic Opentrons_smoothieboard-5driver.sch, sheet 3]

Parts:
C44, C46, C47, C51, C52, C53, C62, C65, C66: .1uF; C0603
C45, C50, C61, C64: 10uF; EIA3216
C48: 1uF; EIA3216
C49: 470pF; C0603K
C54, C55, C56, C57: 18pF; C0603
C58, C59: 12pF; C0603
C60: 100uF; PANASONIC_E
C63: 100uF; PANASONIC_D
D1, D2, D6: MBRA210LT3; SMADIODE
D3: VS-25CTQ045S; TO263AB
D4: B1100-13-F; SMADIODE
D5: 15v; SMB
FB1: FERRITE; 0603
FB2, FB3, FB4: BEAD0603S601A20T; 0603
IC7: 74LVC1G04; SOT23-5
IC8: LAN8720; QFN24_4MM
IC10: LM1117-3.3V; SOT223
IC11: 78L12F; SOT89
IC14: TC4427; SOIC8
J6, J8, J9, J11: MTA02-100; 10X02MTA
J10: POWER_JACKSMD; POWER_JACK_SMD
JP11, JP27, JP28: JP1E; JP1
LED5, LED6, LED7, LED8, LED9, LED10: LEDCHIP-LED0805; CHIP-LED0805
POWER: POWER; MOLEX8981
Q3: 25MHz; CRYSTAL_3.2X2.5
Q6, Q7: AOT240L; TO220BV
Q8, Q9: ZXMN4A06; SOT230P700X160-4N
Q10: SUD50P04-08-GE3; TO252
R50, R61: 330R; R0603
R51, R58, R59, R60, R69, R70, R73, R75, R105, R106, R107, R108: 22R; R0603
R52: 1.5K; R0603
R53, R62: 10K; R0603
R54, R55, R56, R57: 49.9R; R0603
R63: 12.1K; R0603
R64: 1M; R0603
R65, R66, R67, R68: 5.6K; R0603
R71, R72, R74, R76, R89, R90, R91: 10k; R0603
R77: 1k; R0603
R78: 2.2K; R0603
R104: 0R; 0603(1608)
RJ1: HR911105A
U$5, U$6, U$10: 5MMCONN; 1715250000
X6, X7, X8, X10, X11, X12, X13, X15: 180G-2

Connections:
3.3V: C65.1, FB1.1, FB2.1, FB3.2, FB4.2, IC10.2 (OUT), IC10.4 (OUT), R77.2; also elsewhere on the board
5V: C64.A (+), D1.C, D2.C, D6.C, IC10.3 (IN); also elsewhere on the board
5VREG: D6.A; also elsewhere on the board
12VREG: C62.1, C66.1, IC11.1 (VO), IC14.6; also elsewhere on the board
+5V: D2.A, POWER.P$4 (+5V), X12.1
ENET_CRS: R60.2; also elsewhere on the board
ENET_MDC: R107.2; also elsewhere on the board
ENET_MDIO: R108.2; also elsewhere on the board
ENET_REF_CLK: R51.2; also elsewhere on the board
ENET_RXD0: R58.2; also elsewhere on the board
ENET_RXD1: R59.2; also elsewhere on the board
ENET_RX_ER: IC8.10 (RXER), R53.1; also elsewhere on the board
ENET_TXD0: R105.2; also elsewhere on the board
ENET_TXD1: R106.2; also elsewhere on the board
ENET_TX_EN: IC8.16 (TXEN); also elsewhere on the board
GND: C44.2, C45.C (-), C46.2, C47.2, C48.C (-), C49.2, C50.C (-), C51.2, C52.2, C53.2, C54.2, C55.2, C56.2, C57.2, C58.2, C59.2, C60.-, C61.C (-), C62.2, C63.-, C64.C (-), C65.2, C66.2, D4.A, IC7.3 (GND), IC8.THERM (GND), IC10.1 (ADJ), IC11.2 (GND), IC11.2@1 (GND), IC14.3, J10.VIN0 (PWR), LED9.C, LED10.C, POWER.P$2 (GND), POWER.P$3 (GND1), Q6.S, Q7.S, Q8.3 (S), Q9.3 (S), R50.1, R61.1, R62.1, R63.1, R71.1, R72.1, R74.2, R76.2, R89.2, R90.2, R91.2, RJ1.GND, RJ1.SHIELD0, RJ1.SHIELD1, U$5.P$2, X6.2, X11.2, X12.2, X13.2; also elsewhere on the board
GPIO_FET: Q7.G, R70.2, R91.1
LED1/REGOFF: IC8.3 (LED1/REGOFF), RJ1.G+
LED2/NINTSEL: IC8.2 (LED2/NINTSEL), R62.2, RJ1.Y+
MOSFET_DRIVE: C60.+, IC11.3 (VI), J9.2, J11.2, JP11.1, JP27.1, R67.1, R68.1, U$5.P$1, U$6.P$2, U$10.P$2, X10.2, X13.1, X15.2
unnamed: IC14.7, R69.1
unnamed: LED10.A, R78.1
unnamed: J6.2, LED6.C, Q9.4 (D), X8.2
unnamed: IC14.5, R70.1
unnamed: R61.2, RJ1.G-
unnamed: C52.1, C53.1, R54.1, R55.1, R56.1, R57.1, R104.1, RJ1.P4, RJ1.P5
unnamed: IC8.8 (RXD0), R58.1
unnamed: R50.2, RJ1.Y-
unnamed: IC8.7 (RXD1), R59.1
unnamed: IC8.11 (CRS_DV), R60.1
unnamed: C59.1, IC8.4 (XTAL2), Q3.1, R64.2
unnamed: C58.1, IC8.5 (XTAL1), Q3.2, R64.1
unnamed: IC8.24 (RBIAS), R63.2
unnamed: Q8.1 (G), R73.1
unnamed: Q9.1 (G), R75.1
unnamed: IC7.2 (A), IC8.14 (NINT/REFCLKO)
unnamed: IC7.4 (Y), R51.1
unnamed: LED9.A, R77.1
unnamed: LED5.A, R65.2
unnamed: C48.A (+), C49.1, IC8.6 (VDDCR)
unnamed: J8.1, LED5.C, Q8.4 (D), X7.2
unnamed: LED6.A, R66.2
unnamed: J9.1, LED7.C, Q6.D, U$10.P$1, X10.1
unnamed: J11.1, LED8.C, Q7.D, U$6.P$1, X15.1
unnamed: LED7.A, R67.2
unnamed: D5.C, Q10.1 (G), R89.1
unnamed: LED8.A, R68.2
unnamed: C44.1, FB2.2, IC7.5 (VCC)
unnamed: FB3.1, R52.2, R53.2
unnamed: C50.A (+), C51.1, FB4.1, IC8.9 (VDDIO)
unnamed: C45.A (+), C46.1, C47.1, FB1.2, IC8.1 (VDD2A), IC8.19 (VDD1A), R104.2
unnamed: IC8.17 (TXD0), R105.1
unnamed: IC8.18 (TXD1), R106.1
unnamed: IC8.12 (MDIO), R52.1, R108.1
unnamed: IC8.13 (MDC), R107.1
P2.6: R75.2, R76.1; also elsewhere on the board
P2.7: IC14.4, R72.2; also elsewhere on the board
PWM0: R73.2, R74.1; also elsewhere on the board
PWM1: IC14.2, R71.2; also elsewhere on the board
PWM1_FET: Q6.G, R69.2, R90.1
RD_N: C57.1, IC8.22 (RX-), R57.2, RJ1.RD-
RD_P: C56.1, IC8.23 (RX+), R56.2, RJ1.RD+
RSTOUT: IC8.15 (NRST); also elsewhere on the board
SMALL_MOSFET_POWER: C61.A (+), J6.1, J8.2, JP28.1, R65.1, R66.1, X6.1, X7.1, X8.1
TD_N: C55.1, IC8.20 (TX-), R55.2, RJ1.TD-
TD_P: C54.1, IC8.21 (TX+), R54.2, RJ1.TD+
VBB: C63.+, D3.K, D4.C, D5.A, JP11.2, JP27.2, JP28.2, Q10.2 (S), R78.2; also elsewhere on the board
VBB_IN: D3.1 (N/C), D3.2 (A), J10.P$4 (GND), POWER.P$1 (+12V), Q10.3 (D), X11.1
VUSB: D1.A; also elsewhere on the board

Notes on the sheet:
JP13,14 1-2: EXT FET- PS2
2-3: VBB
SMT FET PAIR
Small Power
TO220 FET PAIR
High Power
PWM Channel
GPIO Channel
SmoothieBoard ver 1.0
http://smoothieware.org
VS-25CTQ045S
