OpenTrons/Smoothieboard/Opentrons_smoothieboard-5driver.brd

## EAGLE design Opentrons_smoothieboard-5driver.brd (continued)

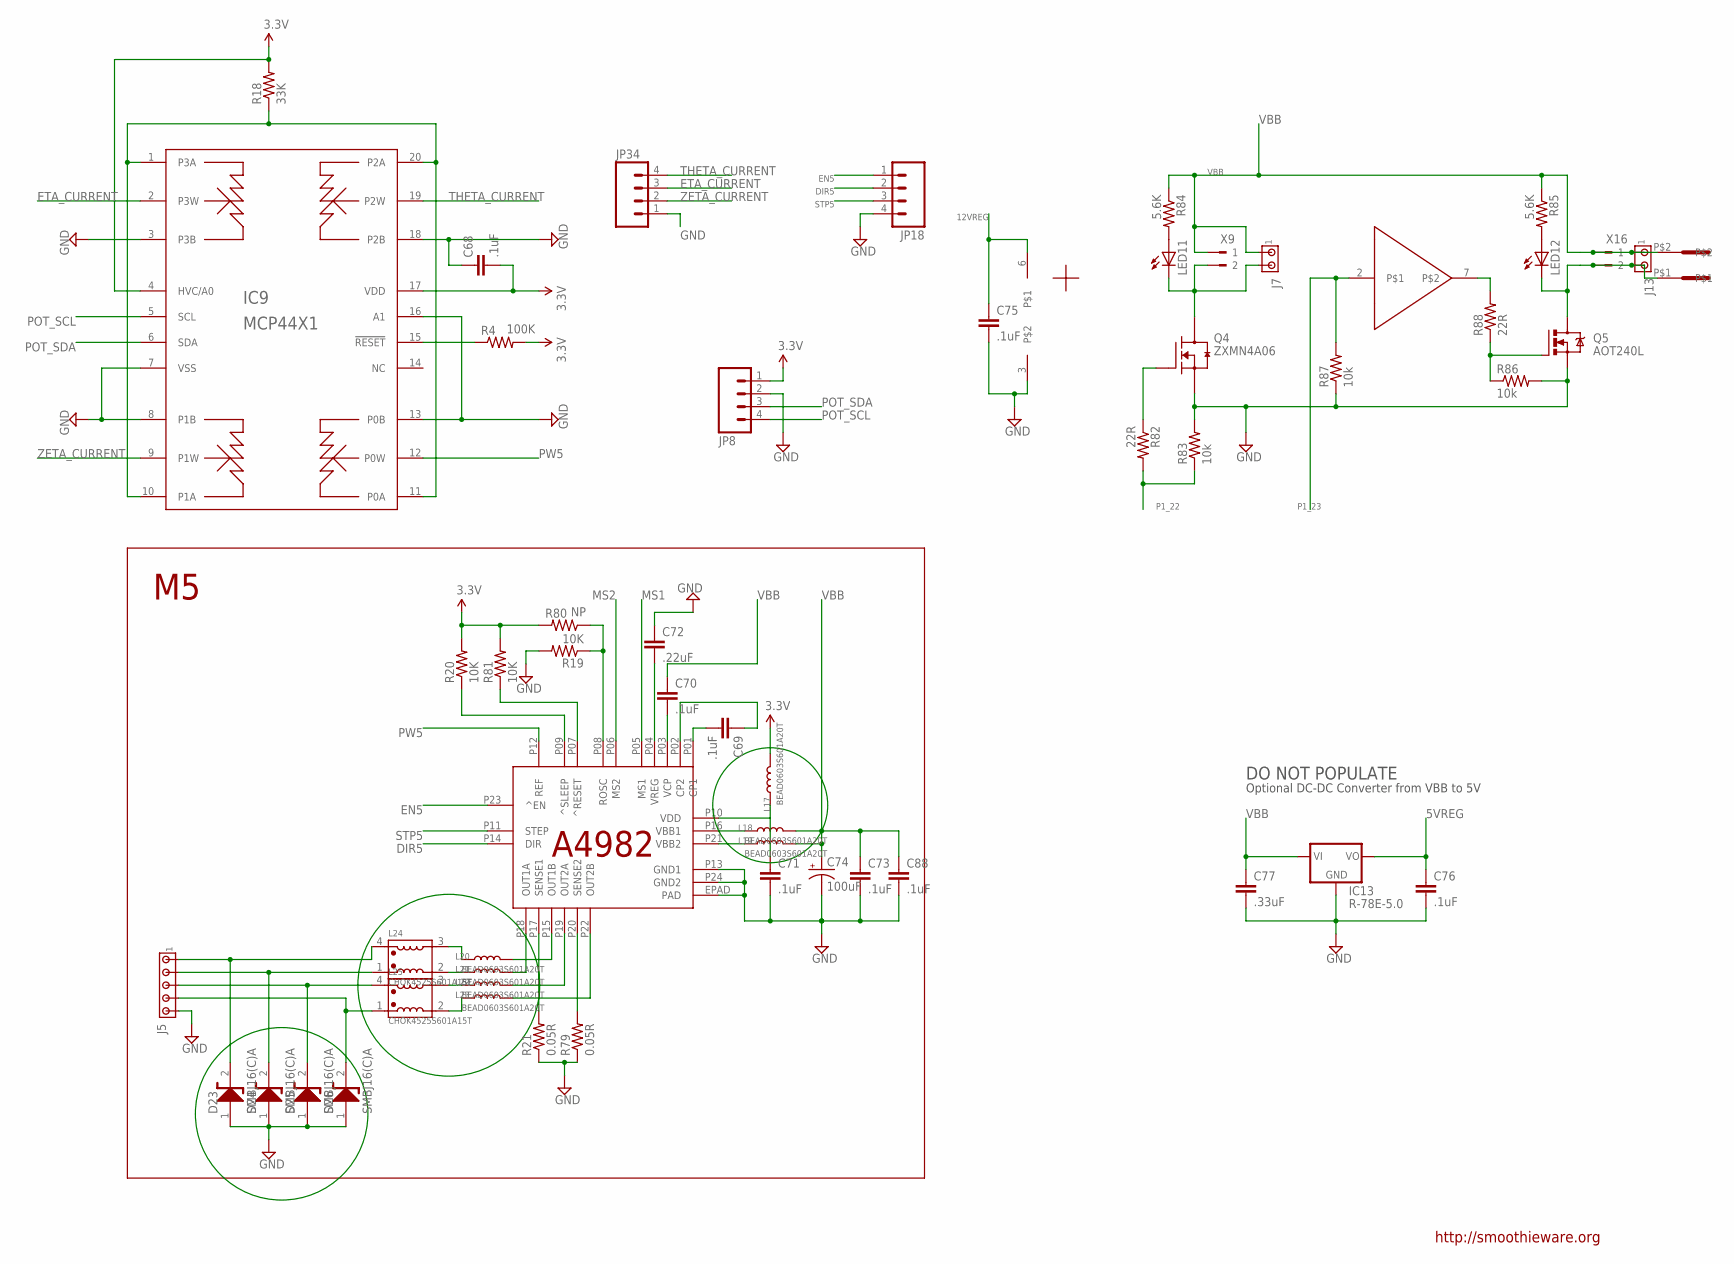
[picture p9: schematic Opentrons_smoothieboard-5driver.sch, sheet 4]

Parts:
C68, C69, C70, C71, C73, C75, C76, C88: .1uF; C0603
C72: .22uF; C0603
C74: 100uF; PANASONIC_E
C77: .33uF; C0603
D23, D24, D25, D26: SMBJ16(C)A; DO214-AA_(SMB)
IC9: MCP44X1; TSSOP20
IC12: A4982; ETSSOP24
IC13: R-78E-5.0; R-78
IC15: TC4427; SOIC8
J5: MTA05-100; 10X05MTA
J7, J13: MTA02-100; 10X02MTA
JP8, JP18, JP34: M041X04_NO_SILK; 1X04_NO_SILK
L17, L18, L19, L20, L21, L22, L23: BEAD0603S601A20T; 0603(1608)
L24, L25: CHOK4525S601A15T; L-4525
LED11, LED12: LEDCHIP-LED0805; CHIP-LED0805
Q4: ZXMN4A06; SOT230P700X160-4N
Q5: AOT240L; TO220BV
R4: 100K; R0603
R18: 33K; R0603
R19, R20, R81: 10K; R0603
R21, R79: 0.05R; R2512
R80: NP; R0603
R82, R88: 22R; R0603
R83, R86, R87: 10k; R0603
R84, R85: 5.6K; R0603
U$7: 5MMCONN; 1715250000
X9, X16: 180G-2

Connections:
3.3V: C68.2, IC9.4 (HVC/A0), IC9.17 (VDD), JP8.1, L17.2, R4.2, R18.2, R20.2, R80.2, R81.2; also elsewhere on the board
5VREG: C76.1, IC13.3 (VO); also elsewhere on the board
12VREG: C75.1, IC15.6; also elsewhere on the board
DIR5: IC12.P14 (DIR), JP18.2; also elsewhere on the board
EN5: IC12.P23 (^EN), JP18.1; also elsewhere on the board
ETA_CURRENT: IC9.2 (P3W), JP34.3
GND: C68.1, C71.2, C72.1, C73.2, C74.-, C75.2, C76.2, C77.2, C88.2, D23.1 (A), D24.1 (A), D25.1 (A), D26.1 (A), IC9.3 (P3B), IC9.7 (VSS), IC9.8 (P1B), IC9.13 (P0B), IC9.16 (A1), IC9.18 (P2B), IC12.EPAD (PAD), IC12.P13 (GND1), IC12.P24 (GND2), IC13.2 (GND), IC15.3, J5.5, JP8.2, JP18.4, JP34.1, Q4.3 (S), Q5.S, R19.2, R21.1, R79.1, R83.2, R86.2, R87.1; also elsewhere on the board
GPIO_FET1: Q5.G, R86.1, R88.1
J5_1A: D23.2 (K), J5.1, L24.4
J5_1B: D24.2 (K), J5.2, L24.1
J5_2A: D25.2 (K), J5.3, L25.4
J5_2B: D26.2 (K), J5.4, L25.1
MS1: IC12.P05 (MS1); also elsewhere on the board
MS2: IC12.P06 (MS2); also elsewhere on the board
unnamed: IC9.15 (!RESET), R4.1
unnamed: J7.2, LED11.C, Q4.4 (D), X9.2
unnamed: IC9.1 (P3A), IC9.10 (P1A), IC9.11 (P0A), IC9.20 (P2A), R18.1
unnamed: C69.2, IC12.P01 (CP1)
unnamed: C69.1, IC12.P02 (CP2)
unnamed: C70.2, IC12.P03 (VCP)
unnamed: IC12.P17 (SENSE1), R21.2
unnamed: IC12.P20 (SENSE2), R79.2
unnamed: IC12.P18 (OUT1A), L21.2
unnamed: IC12.P15 (OUT1B), L20.2
unnamed: IC12.P19 (OUT2A), L22.2
unnamed: IC12.P22 (OUT2B), L23.2
unnamed: IC12.P08 (ROSC), R19.1, R80.1
unnamed: C72.2, IC12.P04 (VREG)
unnamed: IC12.P09 (^SLEEP), R20.1
unnamed: IC12.P07 (^RESET), R81.1
unnamed: Q4.1 (G), R82.1
unnamed: LED11.A, R84.2
unnamed: J13.2, LED12.C, Q5.D, U$7.P$1, X16.2
unnamed: LED12.A, R85.2
unnamed: IC15.7, R88.2
unnamed: C71.1, IC12.P10 (VDD), L17.1
unnamed: IC12.P16 (VBB1), L18.1
unnamed: IC12.P21 (VBB2), L19.1
unnamed: L21.1, L24.2
unnamed: L20.1, L24.3
unnamed: L22.1, L25.3
unnamed: L23.1, L25.2
P1_22: R82.2, R83.1; also elsewhere on the board
P1_23: IC15.2, R87.2; also elsewhere on the board
POT_SCL: IC9.5 (SCL), JP8.4; also elsewhere on the board
POT_SDA: IC9.6 (SDA), JP8.3; also elsewhere on the board
PW5: IC9.12 (P0W), IC12.P12 (REF)
STP5: IC12.P11 (STEP), JP18.3; also elsewhere on the board
THETA_CURRENT: IC9.19 (P2W), JP34.4
VBB: C70.1, C73.1, C74.+, C77.1, C88.1, IC13.1 (VI), J7.1, J13.1, L18.2, L19.2, R84.1, R85.1, U$7.P$2, X9.1, X16.1; also elsewhere on the board
ZETA_CURRENT: IC9.9 (P1W), JP34.2

Notes on the sheet:
http://smoothieware.org
DO NOT POPULATE
Optional DC-DC Converter from VBB to 5V

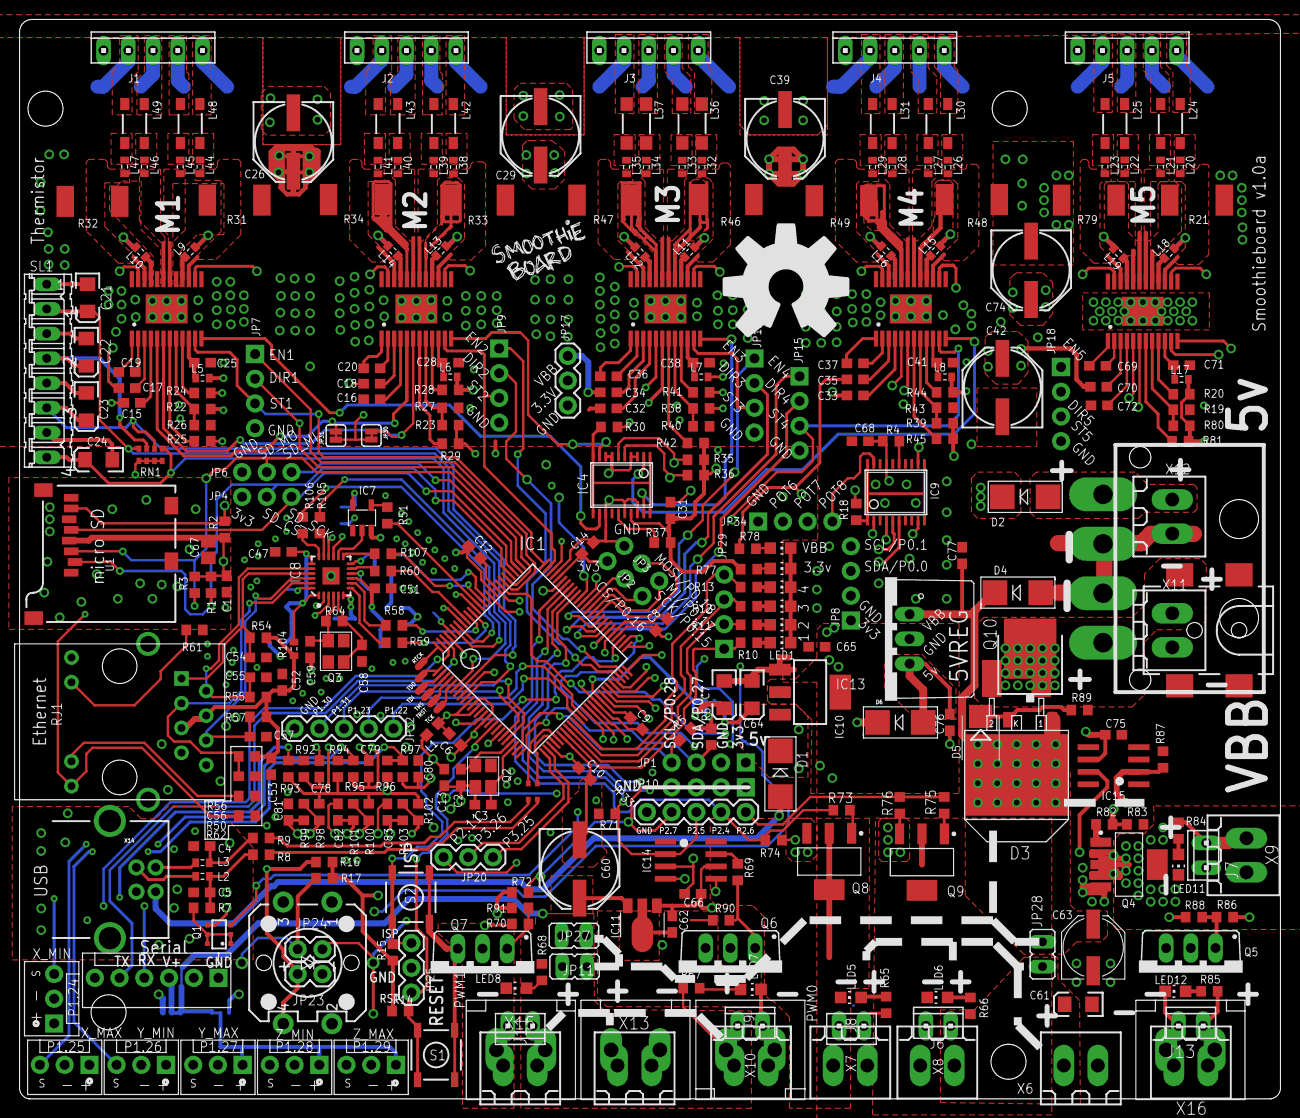
[picture p10: board Opentrons_smoothieboard-5driver.brd from above]

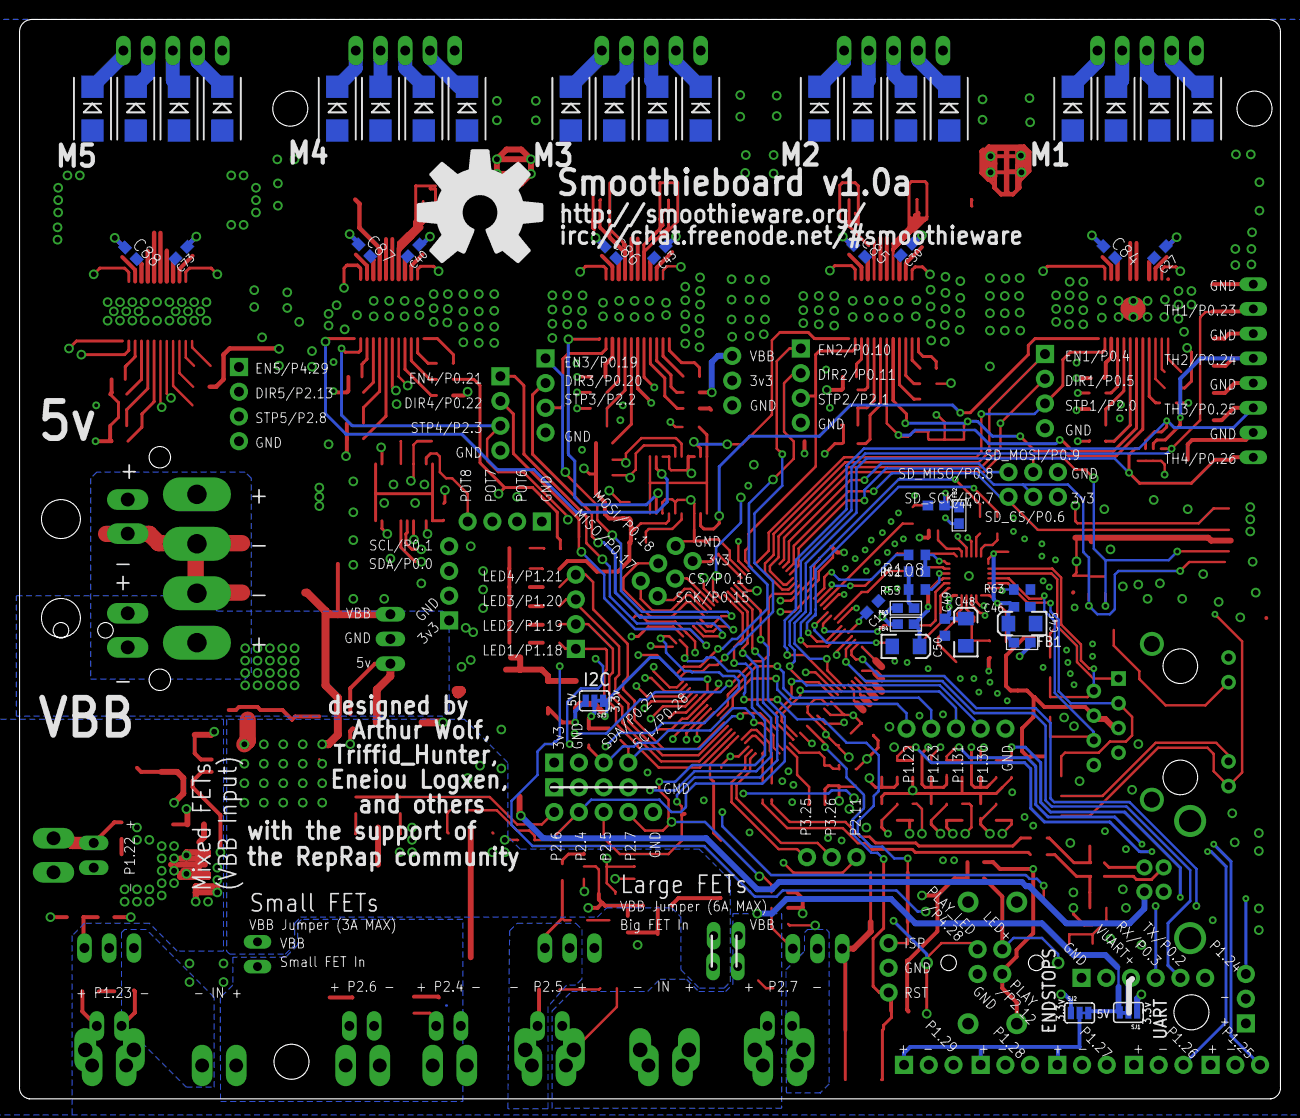
[picture p11: board Opentrons_smoothieboard-5driver.brd from below]

Board: 4 copper layers, 129.6 x 110.9 mm, 385 parts (49 on the bottom side), 292 nets.
